jordi2224/DQNavigator/Figure_1.png

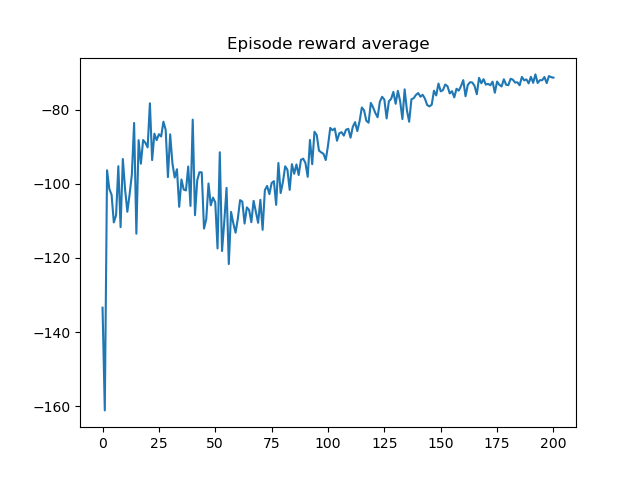
Figure_1.png
