jordi2224/DQNavigator/model.png

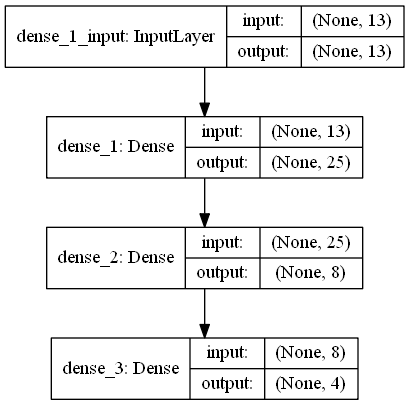
model.png
