jordi2224/DQNavigator/model_plot.png

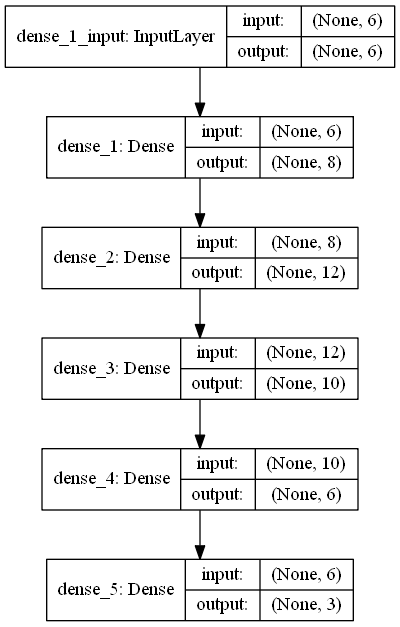
model_plot.png
