jordi2224/DQNavigator/preprocessing/decimated.png

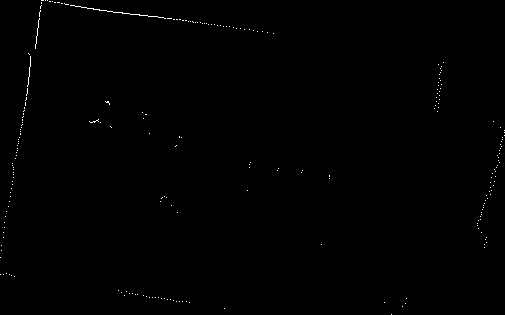
preprocessing/decimated.png
