jordi2224/DQNavigator/preprocessing/grids/grid0.png

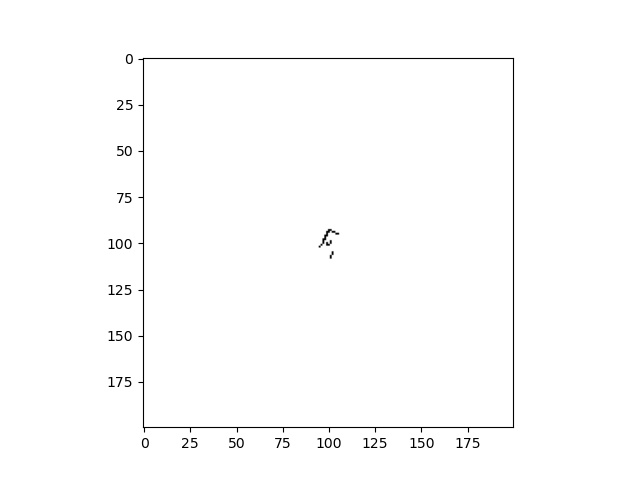
preprocessing/grids/grid0.png
