jordi2224/DQNavigator/preprocessing/grids/grid1.png

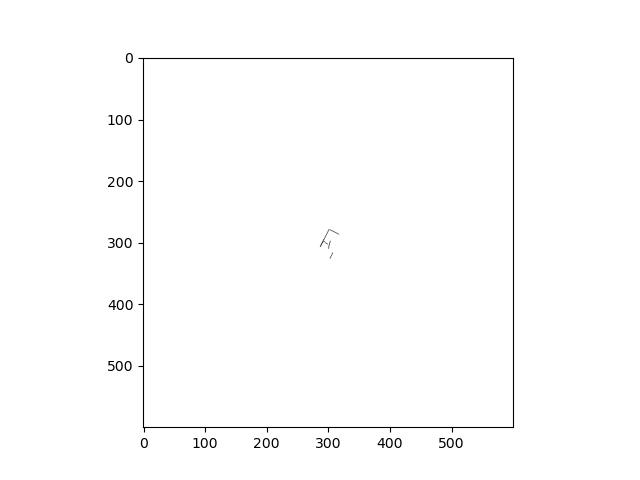
preprocessing/grids/grid1.png
