jordi2224/DQNavigator/preprocessing/grids/grid7.png

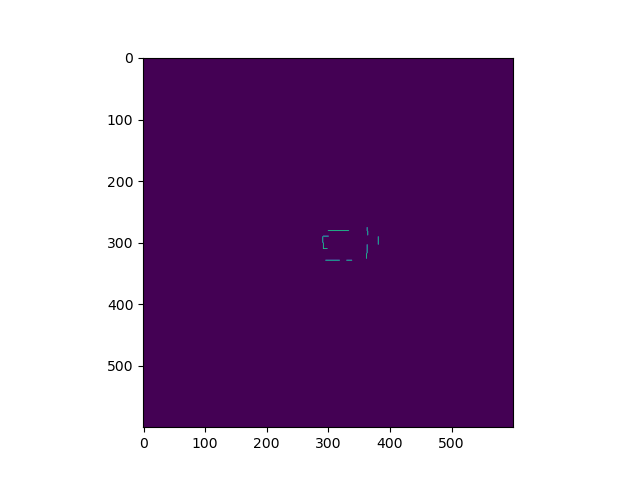
preprocessing/grids/grid7.png
