jordi2224/DQNavigator/preprocessing/grids/grid14.png

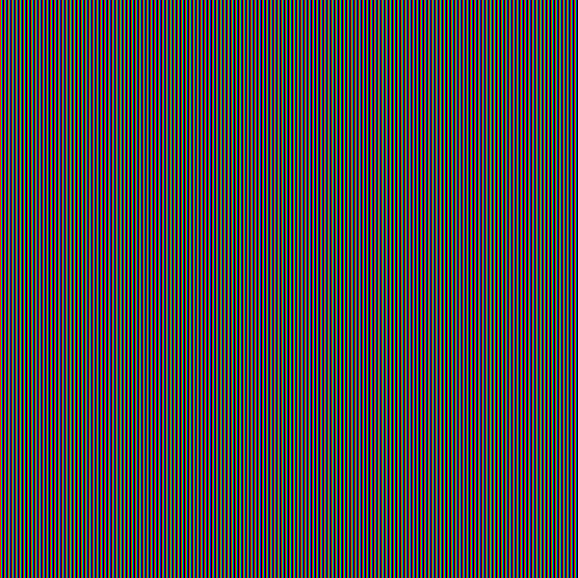
preprocessing/grids/grid14.png
