jordi2224/DQNavigator/preprocessing/sc_grids/grid2.png

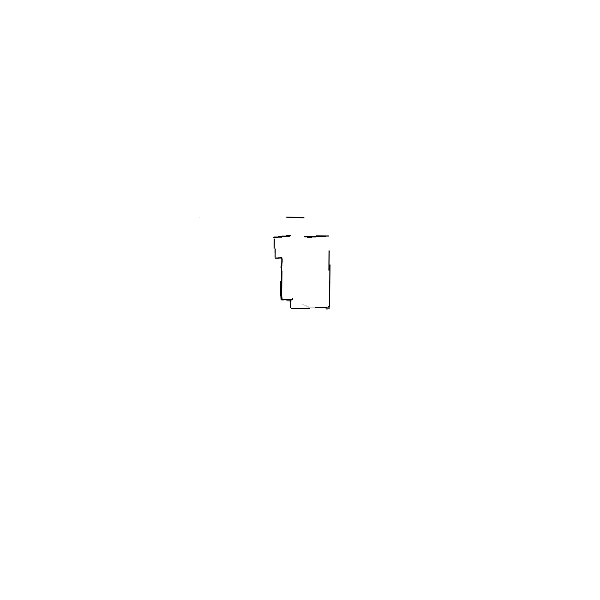
preprocessing/sc_grids/grid2.png
