jordi2224/DQNavigator/hardware/ROVER/LIDAR_support.stl

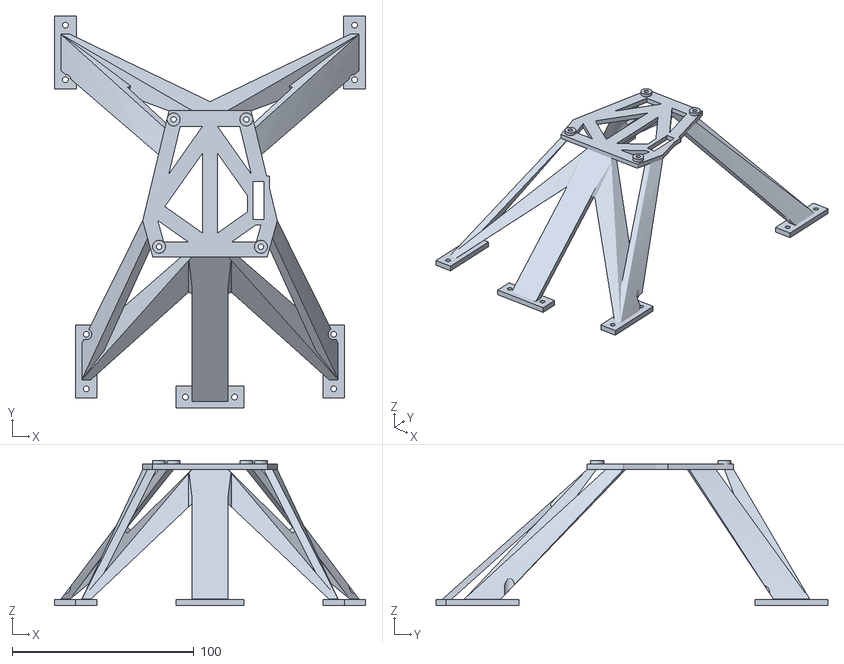
[picture p10: CAD file, 2020-07-13]
hardware/ROVER/LIDAR_support.stl
171.0 x 215.5 x 80.0
