jordi2224/DQNavigator/hardware/ROVER/PCB_deck.stl

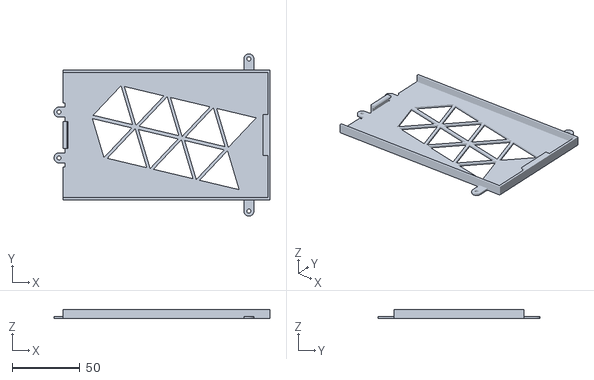
[picture p11: CAD file, 2020-07-13]
hardware/ROVER/PCB_deck.stl
159.3 x 119.6 x 7.00
