jordi2224/DQNavigator/hardware/ROVER/battery-strap casing.stl

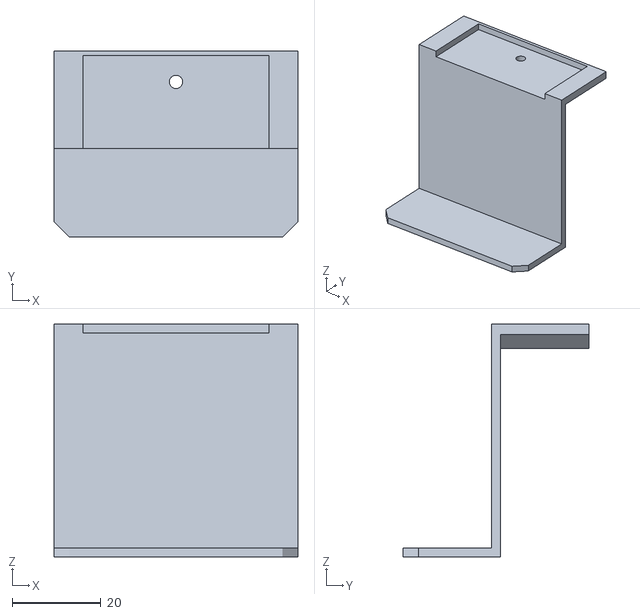
[picture p12: CAD file, 2020-04-13]
hardware/ROVER/battery-strap casing.stl
55.0 x 42.0 x 52.5
