jordi2224/DQNavigator/hardware/ROVER/battery-strap -under.stl

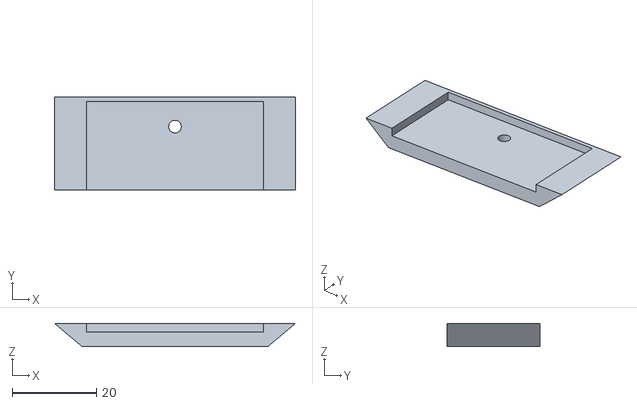
[picture p13: CAD file, 2020-04-13]
hardware/ROVER/battery-strap -under.stl
57.1 x 22.0 x 5.50
