jordi2224/DQNavigator/hardware/ROVER/stabilizer.stl

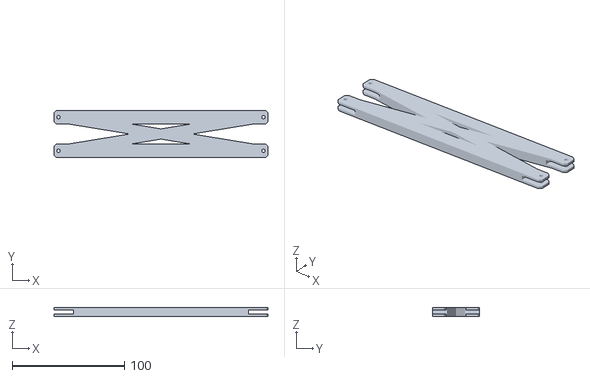
[picture p14: CAD file, 2020-04-13]
hardware/ROVER/stabilizer.stl
191.0 x 42.0 x 7.60
