jordi2224/DQNavigator/hardware/ROVER/Deck.stl

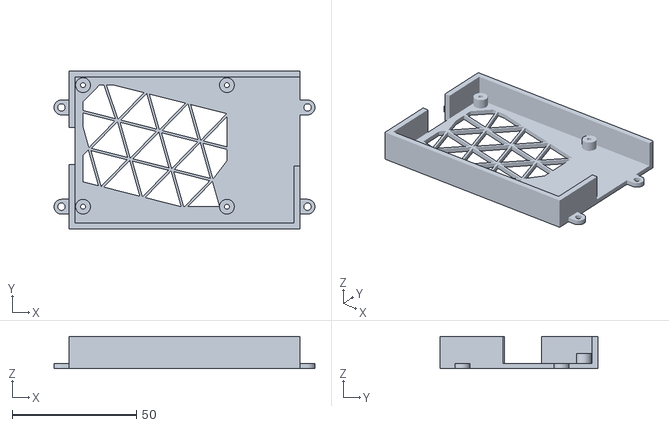
[picture p15: CAD file, 2020-04-13]
hardware/ROVER/Deck.stl
105.2 x 63.7 x 13.0
