jordi2224/DQNavigator/hardware/ROVER/Tplug.stl

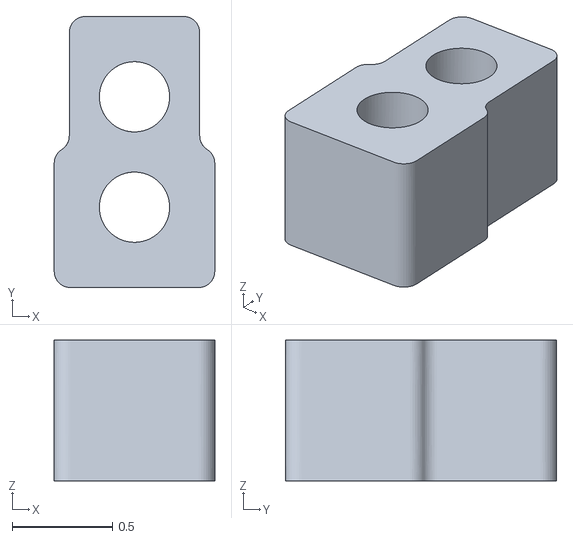
[picture p16: CAD file, 2020-04-13]
hardware/ROVER/Tplug.stl
0.8 x 1.35 x 0.7
