jordi2224/DQNavigator/hardware/ROVER/washer.stl

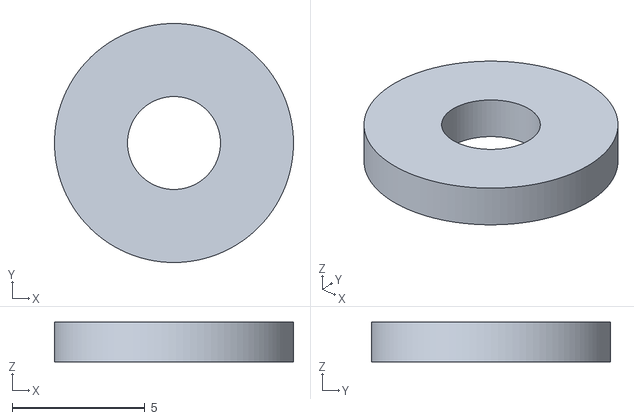
[picture p17: CAD file, 2020-04-13]
hardware/ROVER/washer.stl
9.00 x 9.00 x 1.50
