jordi2224/DQNavigator/(list of files, cad)

Other CAD files:
hardware/ROVER/Deck0.SLDPRT
hardware/ROVER/Deck.ipt
hardware/ROVER/LIDAR_support.idw
hardware/ROVER/LIDAR_support.ipt
hardware/ROVER/OldVersions/Deck.0004.ipt
hardware/ROVER/OldVersions/LIDAR_support.0001.idw
hardware/ROVER/OldVersions/LIDAR_support.0010.ipt
hardware/ROVER/OldVersions/PCB_deck.0003.ipt
hardware/ROVER/OldVersions/Part3.0001.ipt
hardware/ROVER/OldVersions/Tplug-Male.0008.ipt
hardware/ROVER/OldVersions/Tplug.0004.ipt
hardware/ROVER/OldVersions/battery-strap -under.0001.ipt
hardware/ROVER/OldVersions/decks.0003.idw
hardware/ROVER/OldVersions/floormap2.0002.idw
hardware/ROVER/OldVersions/floormap2.0004.ipt
hardware/ROVER/OldVersions/full_assembly.0002.idw
hardware/ROVER/OldVersions/full_assembly.0006.iam
hardware/ROVER/OldVersions/motor_body.0001.ipt
hardware/ROVER/OldVersions/motor_core.0001.iam
hardware/ROVER/OldVersions/motor_plus_encoder.0001.iam
hardware/ROVER/OldVersions/motor_plus_encoder.0001.idw
hardware/ROVER/OldVersions/platform.0007.idw
hardware/ROVER/OldVersions/platform.0010.iam
hardware/ROVER/OldVersions/platform_motor.0003.ipt
hardware/ROVER/OldVersions/platform_sprocket.0002.ipt
hardware/ROVER/OldVersions/platform_track_support.0008.ipt
hardware/ROVER/OldVersions/platform_track_support_inv.0001.ipt
hardware/ROVER/OldVersions/platform_wheel.0002.ipt
hardware/ROVER/OldVersions/stabilizer.0009.ipt
hardware/ROVER/OldVersions/washer.0002.ipt
hardware/ROVER/PCB_deck.dwg
hardware/ROVER/PCB_deck.ipt
hardware/ROVER/Part1.ipt
hardware/ROVER/Part3.ipt
hardware/ROVER/Tplug-Male.ipt
hardware/ROVER/Tplug.dwg
hardware/ROVER/Tplug.ipt
hardware/ROVER/battery-strap -under.ipt
hardware/ROVER/battery-strap casing.ipt
hardware/ROVER/battery-strap.idw
hardware/ROVER/decks.idw
hardware/ROVER/encoder_pole.ipt
hardware/ROVER/encoder_sensor.ipt
hardware/ROVER/floormap-1.idw
hardware/ROVER/floormap.ipt
hardware/ROVER/floormap2.idw
hardware/ROVER/floormap2.ipt
hardware/ROVER/full_assembly.iam
hardware/ROVER/full_assembly.idw
hardware/ROVER/gearbox.ipt
hardware/ROVER/motor.iam
hardware/ROVER/motor_body.ipt
hardware/ROVER/motor_core.iam
hardware/ROVER/motor_plus_encoder.iam
hardware/ROVER/motor_plus_encoder.idw
hardware/ROVER/pcb.ipt
hardware/ROVER/platform.iam
hardware/ROVER/platform.idw
hardware/ROVER/platform_board.idw
hardware/ROVER/platform_board.ipt
hardware/ROVER/platform_motor.ipt
hardware/ROVER/platform_sprocket.ipt
hardware/ROVER/platform_track_support.ipt
hardware/ROVER/platform_track_support_inv.ipt
hardware/ROVER/platform_wheel.ipt
hardware/ROVER/raspberry.ipt
hardware/ROVER/shaft.ipt
hardware/ROVER/stabilizer.idw
hardware/ROVER/stabilizer.ipt
hardware/ROVER/washer.ipt
