jordi2224/DQNavigator/TODO.txt

Neural Net Training:
	HyperParameter tuning
	Actual training

Data Preprocessing
	Turn driver into object
	Find walls; Using houghlinesP?
	Find hazards
	
Hardware
	Finish Hbridge and current sensing
	Hall effect sensor
	Footprints
	PCB design
	PCB manufacturing
	Assembling

Async movement tracking -> multi threading
Positioning system
Map
Remove dsize dependency

Code Refactor and project cleanup
