jordi2224/DQNavigator/hardware/ROVER/LIDAR_support.pdf

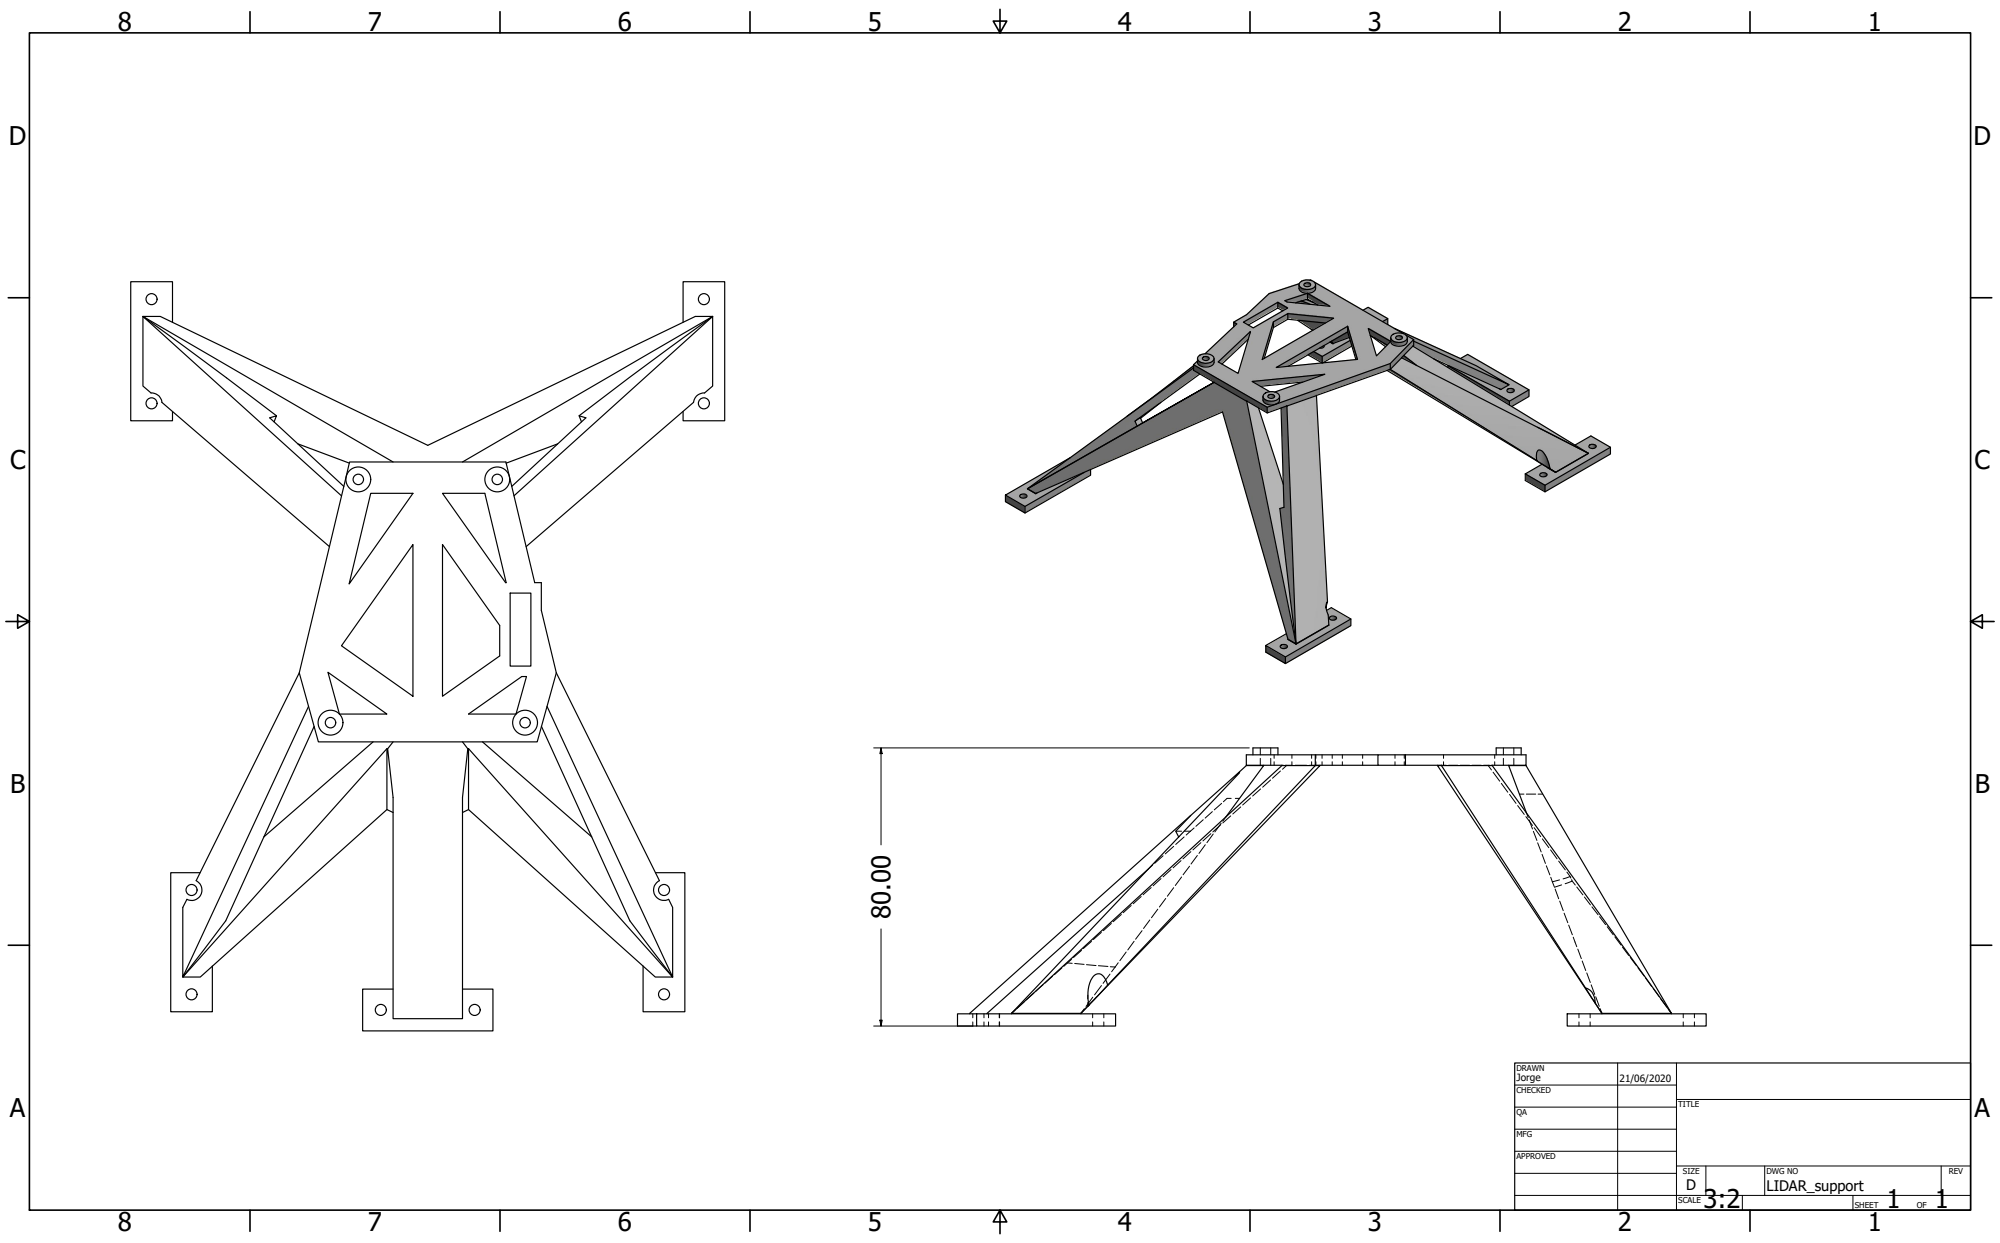
[picture p18: page 1]

DRAWN Jorge | 21/06/2020

CHECKED

MFG

APPROVED

SIZE D | DWG NO LIDAR_support | REV

3:2 SCALE | | SHEET 1 OF 1
