jordi2224/DQNavigator/hardware/ROVER/motor_plus_encoder.pdf

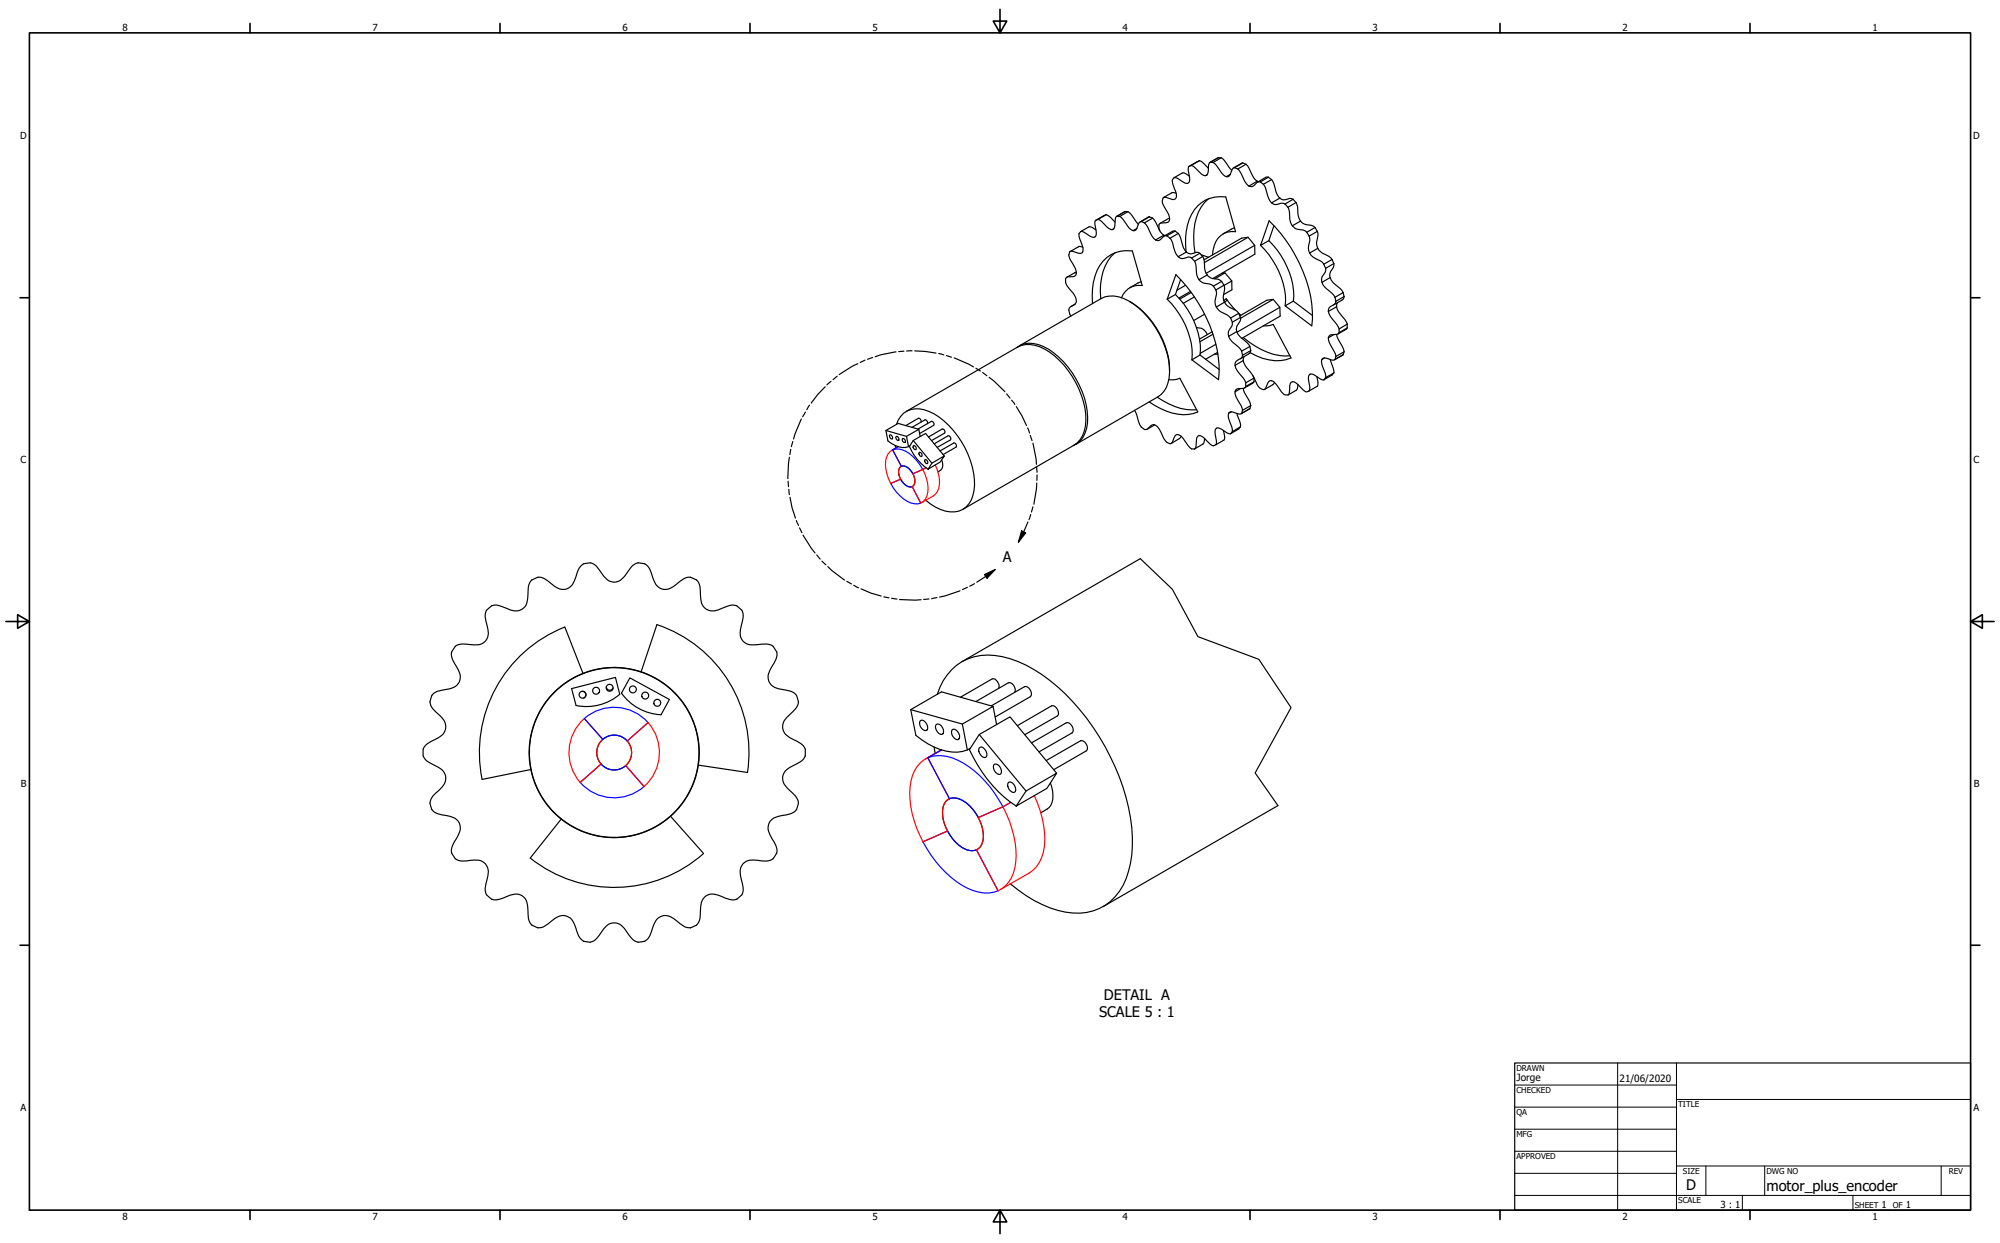
[picture p19: page 1]
DETAIL A SCALE 5 : 1

DRAWN Jorge | 21/06/2020

CHECKED

MFG

APPROVED

SIZE D | DWG NO motor_plus_encoder | REV

SCALE 3 : 1 | | SHEET 1 OF 1
