jordi2224/DQNavigator/hardware/ROVER/decks.pdf

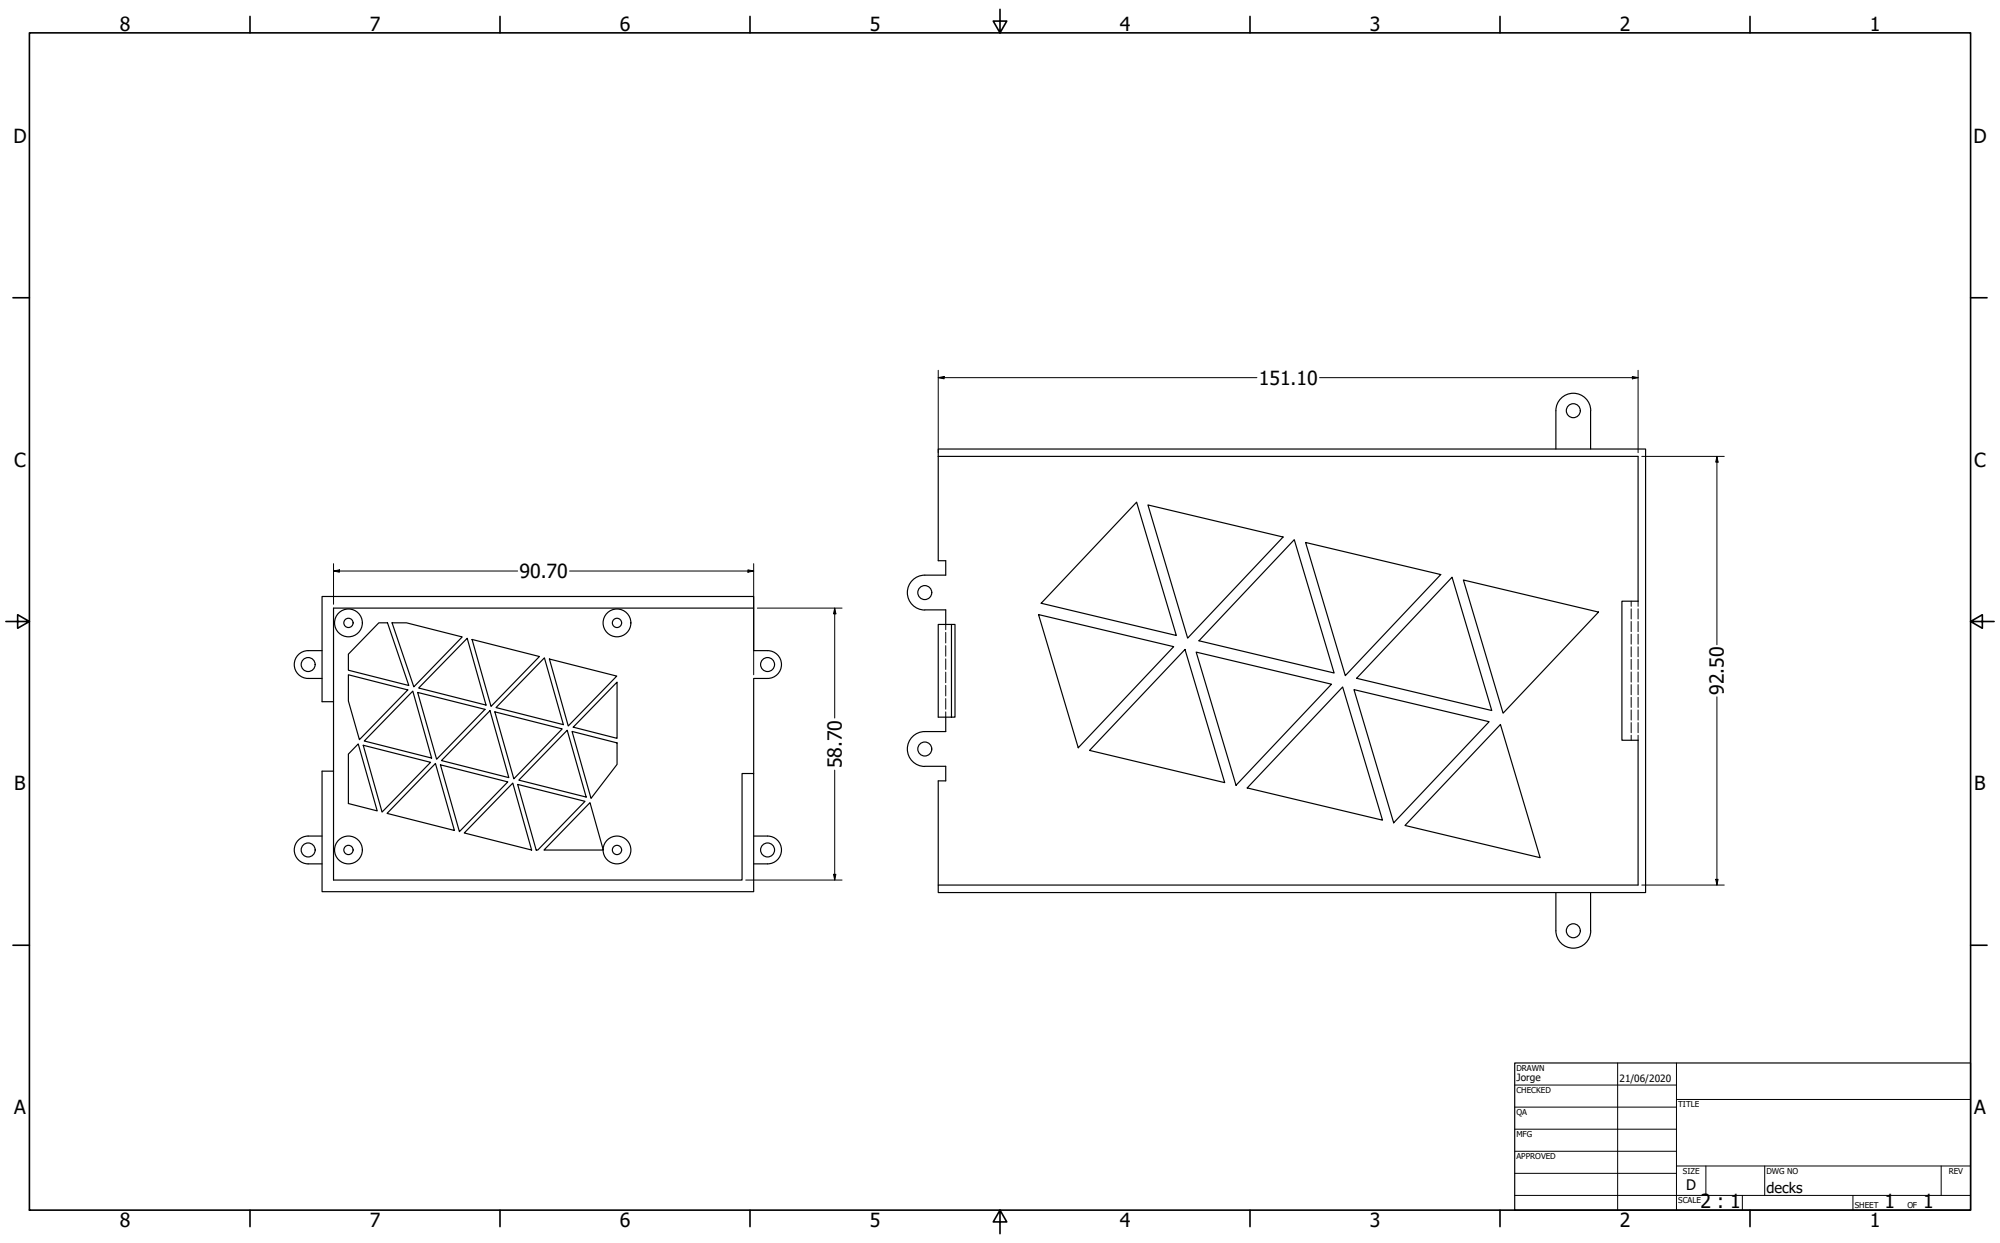
[picture p20: page 1]
