jordi2224/DQNavigator/hardware/ROVER/floormap-1.pdf

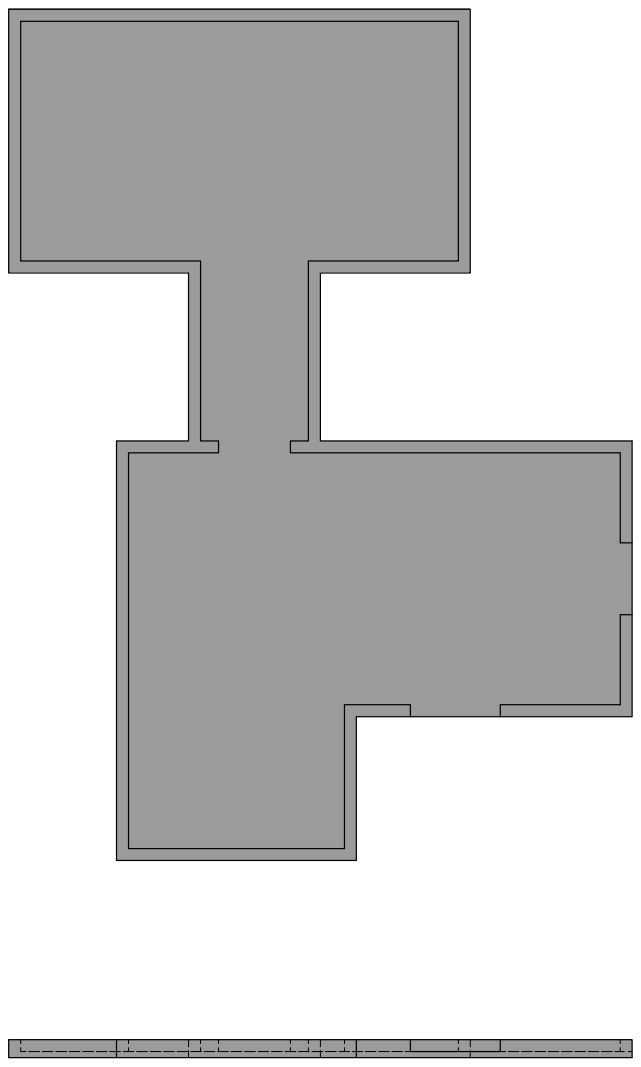
[picture p21: page 1]

DRAWN Jorge | 17/06/2020

CHECKED

MFG

APPROVED

SIZE D | DWG NO | REV

SCALE 1 / 40 | | SHEET 1 OF 1
