jordi2224/DQNavigator/hardware/ROVER/floormap2.pdf

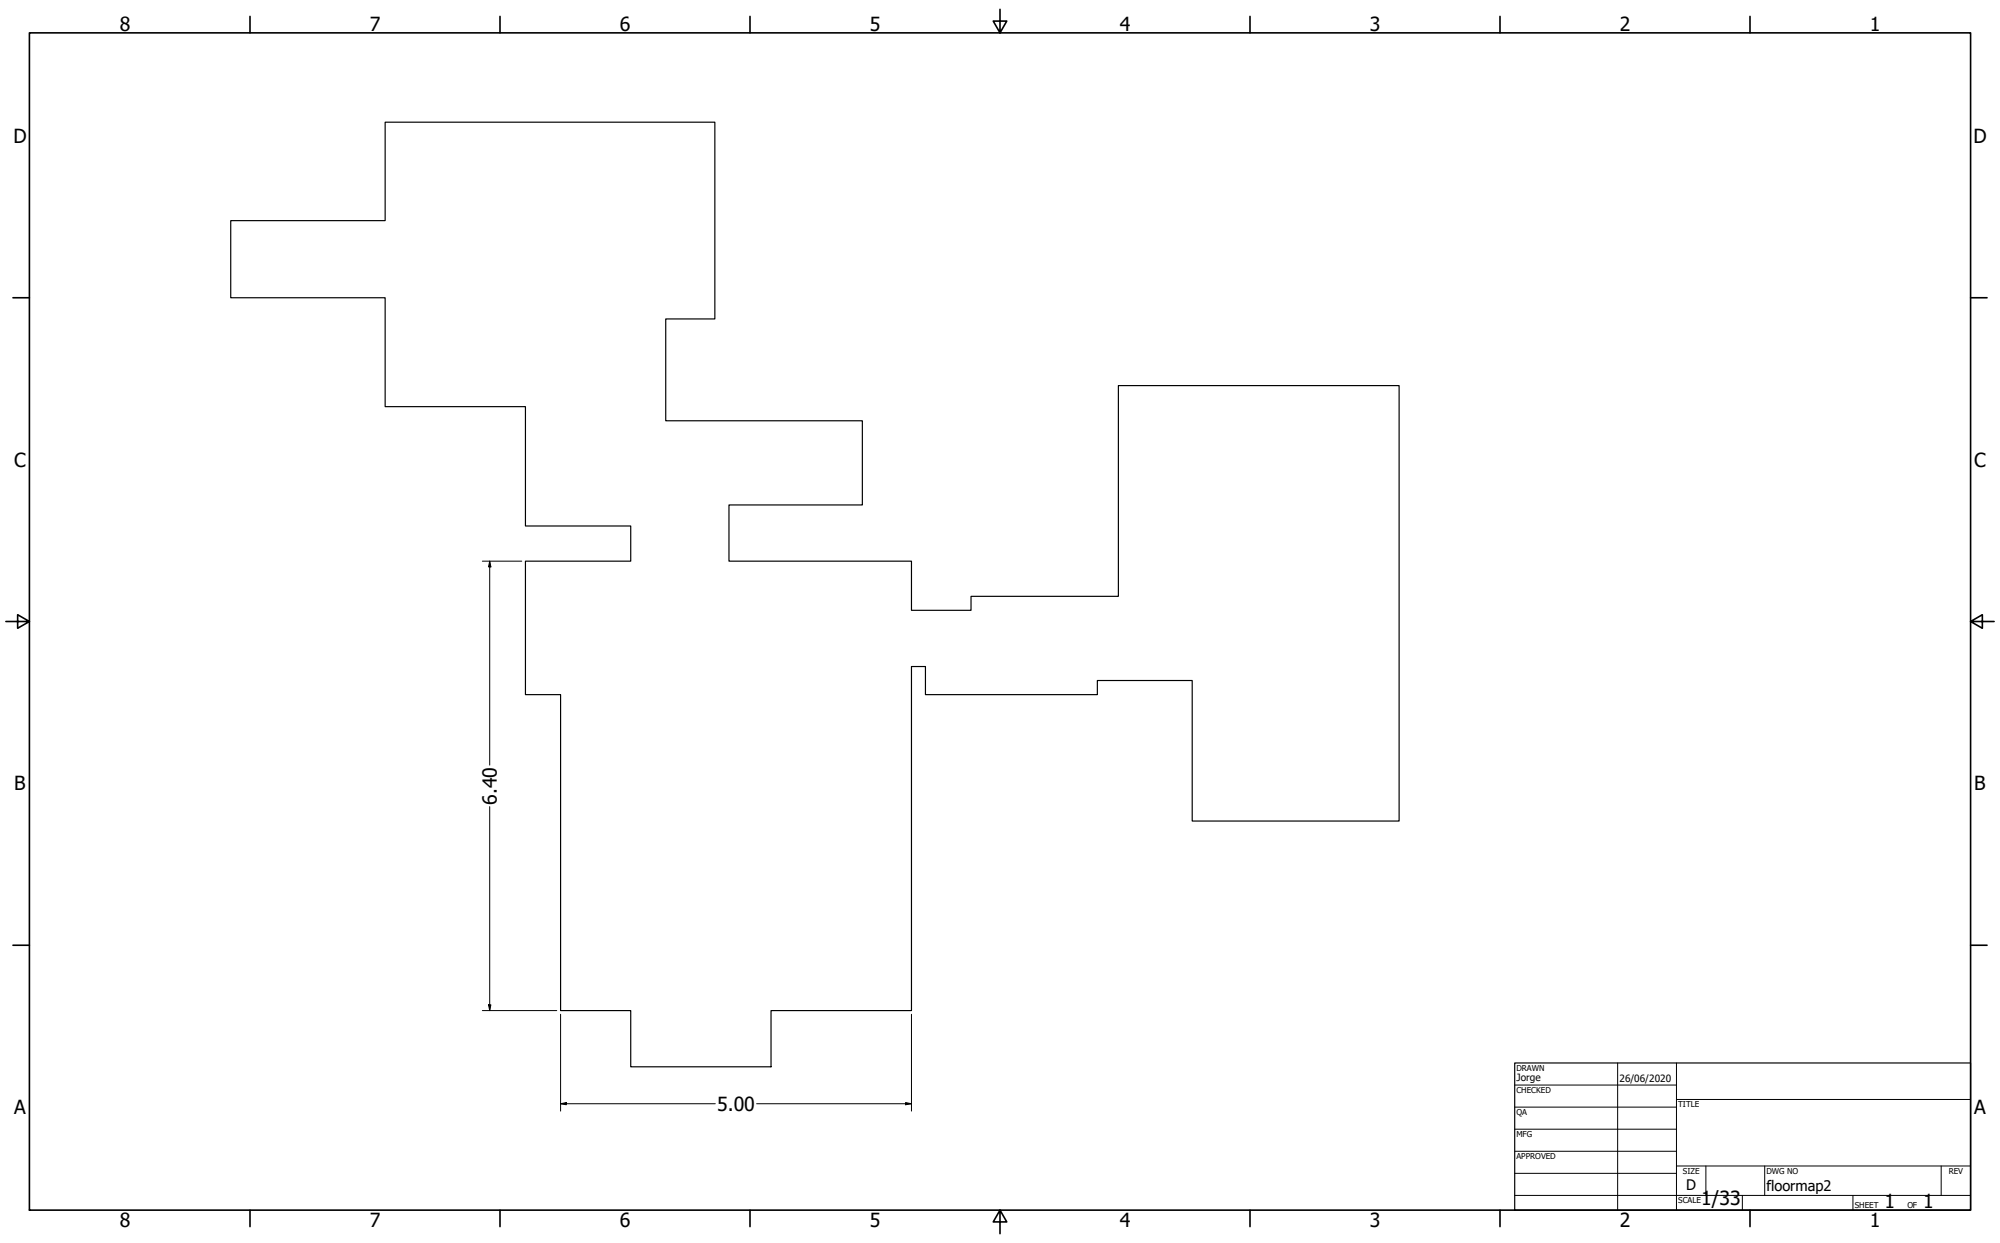
[picture p22: page 1]

DRAWN Jorge | 26/06/2020

CHECKED

MFG

APPROVED

SIZE D | DWG NO floormap2 | REV

1/33 SCALE | | SHEET 1 OF 1
