jordi2224/DQNavigator/hardware/ROVER/full_assembly.pdf

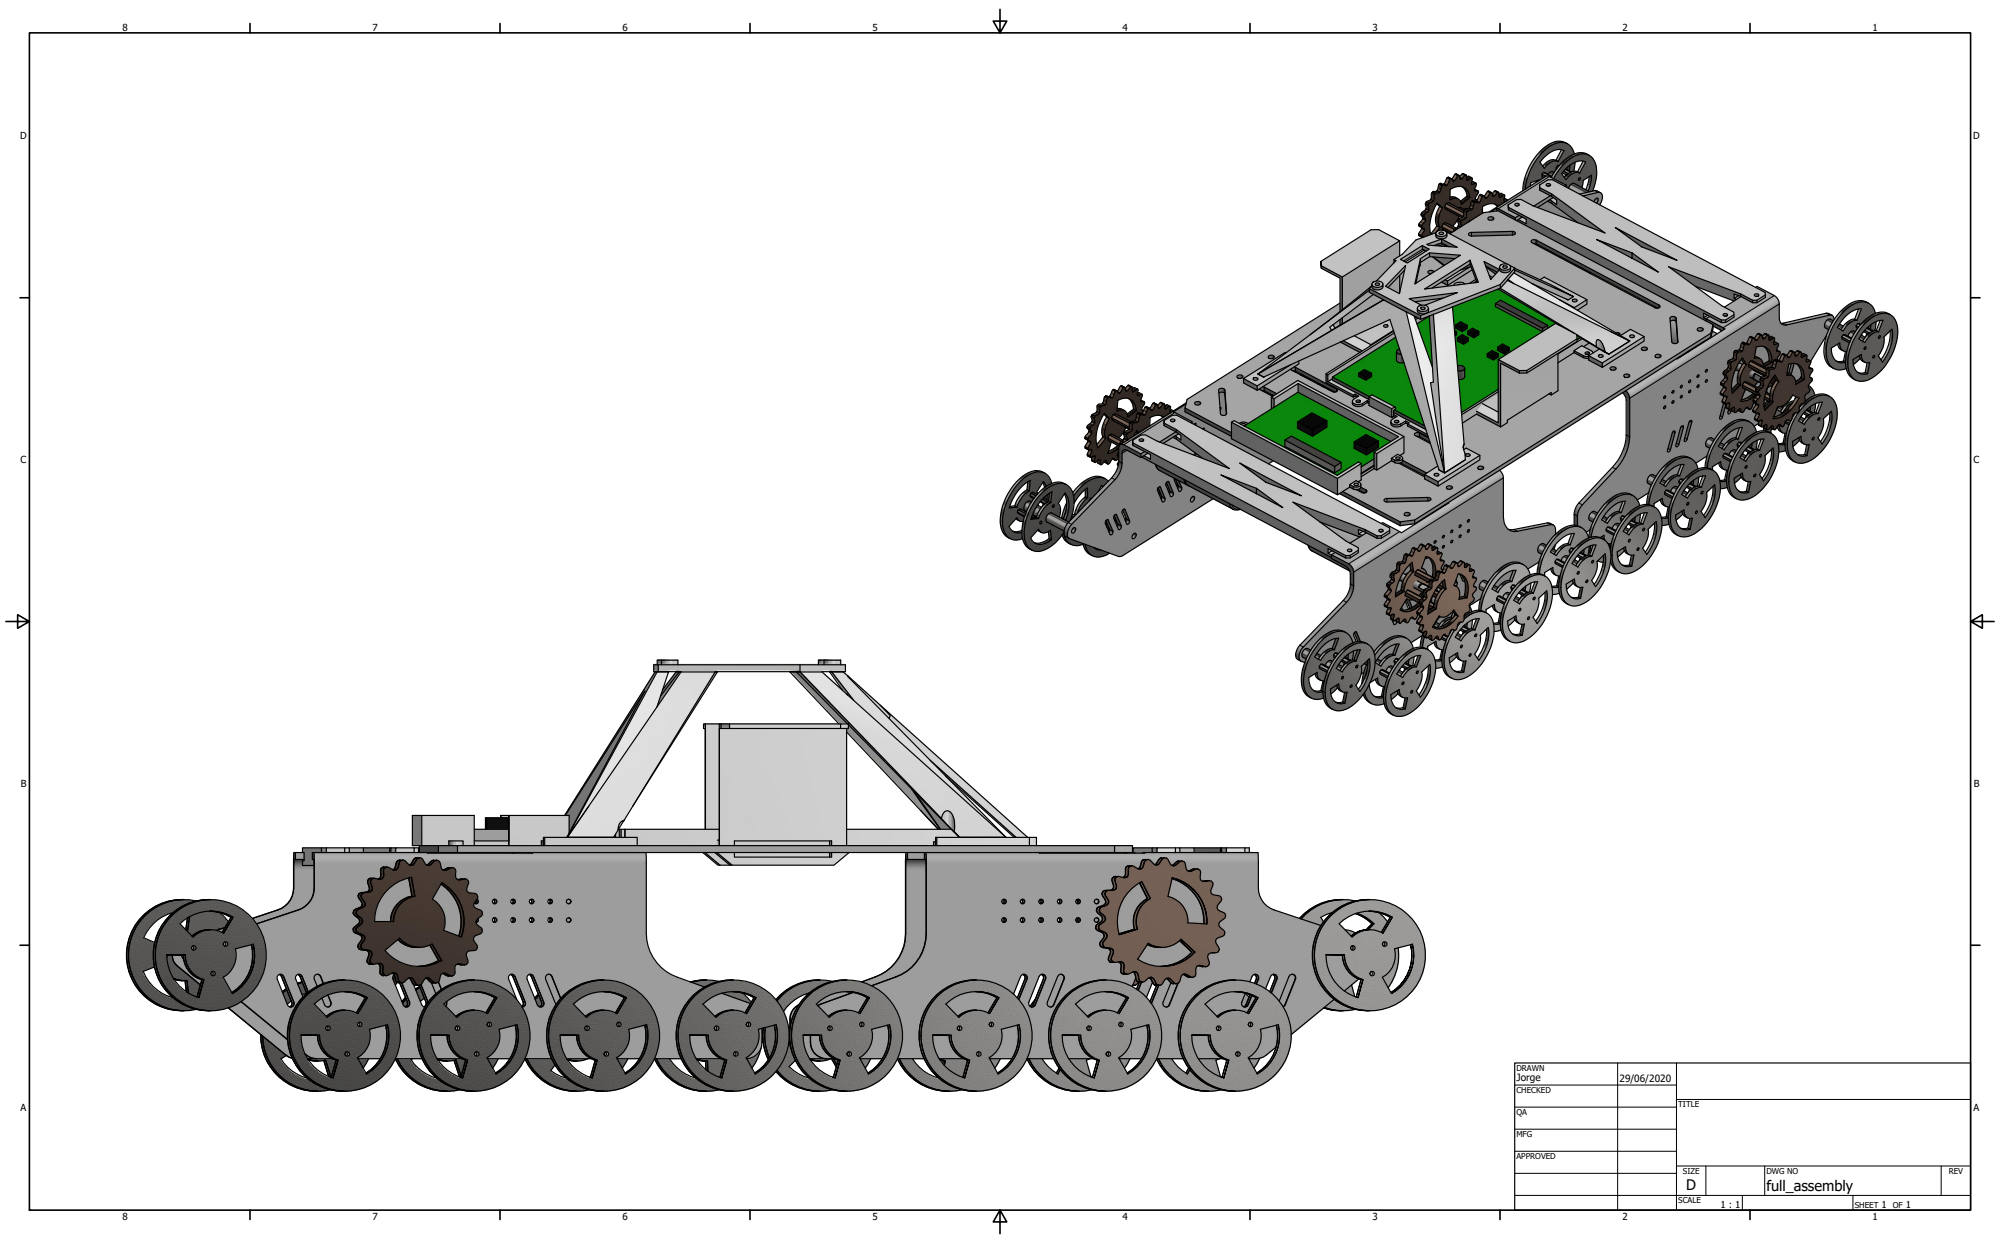
[picture p23: page 1]

DRAWN Jorge | 29/06/2020

CHECKED

MFG

APPROVED

SIZE D | DWG NO full_assembly | REV

SCALE 1 : 1 | | SHEET 1 OF 1
