jordi2224/DQNavigator/hardware/ROVER/platform.pdf

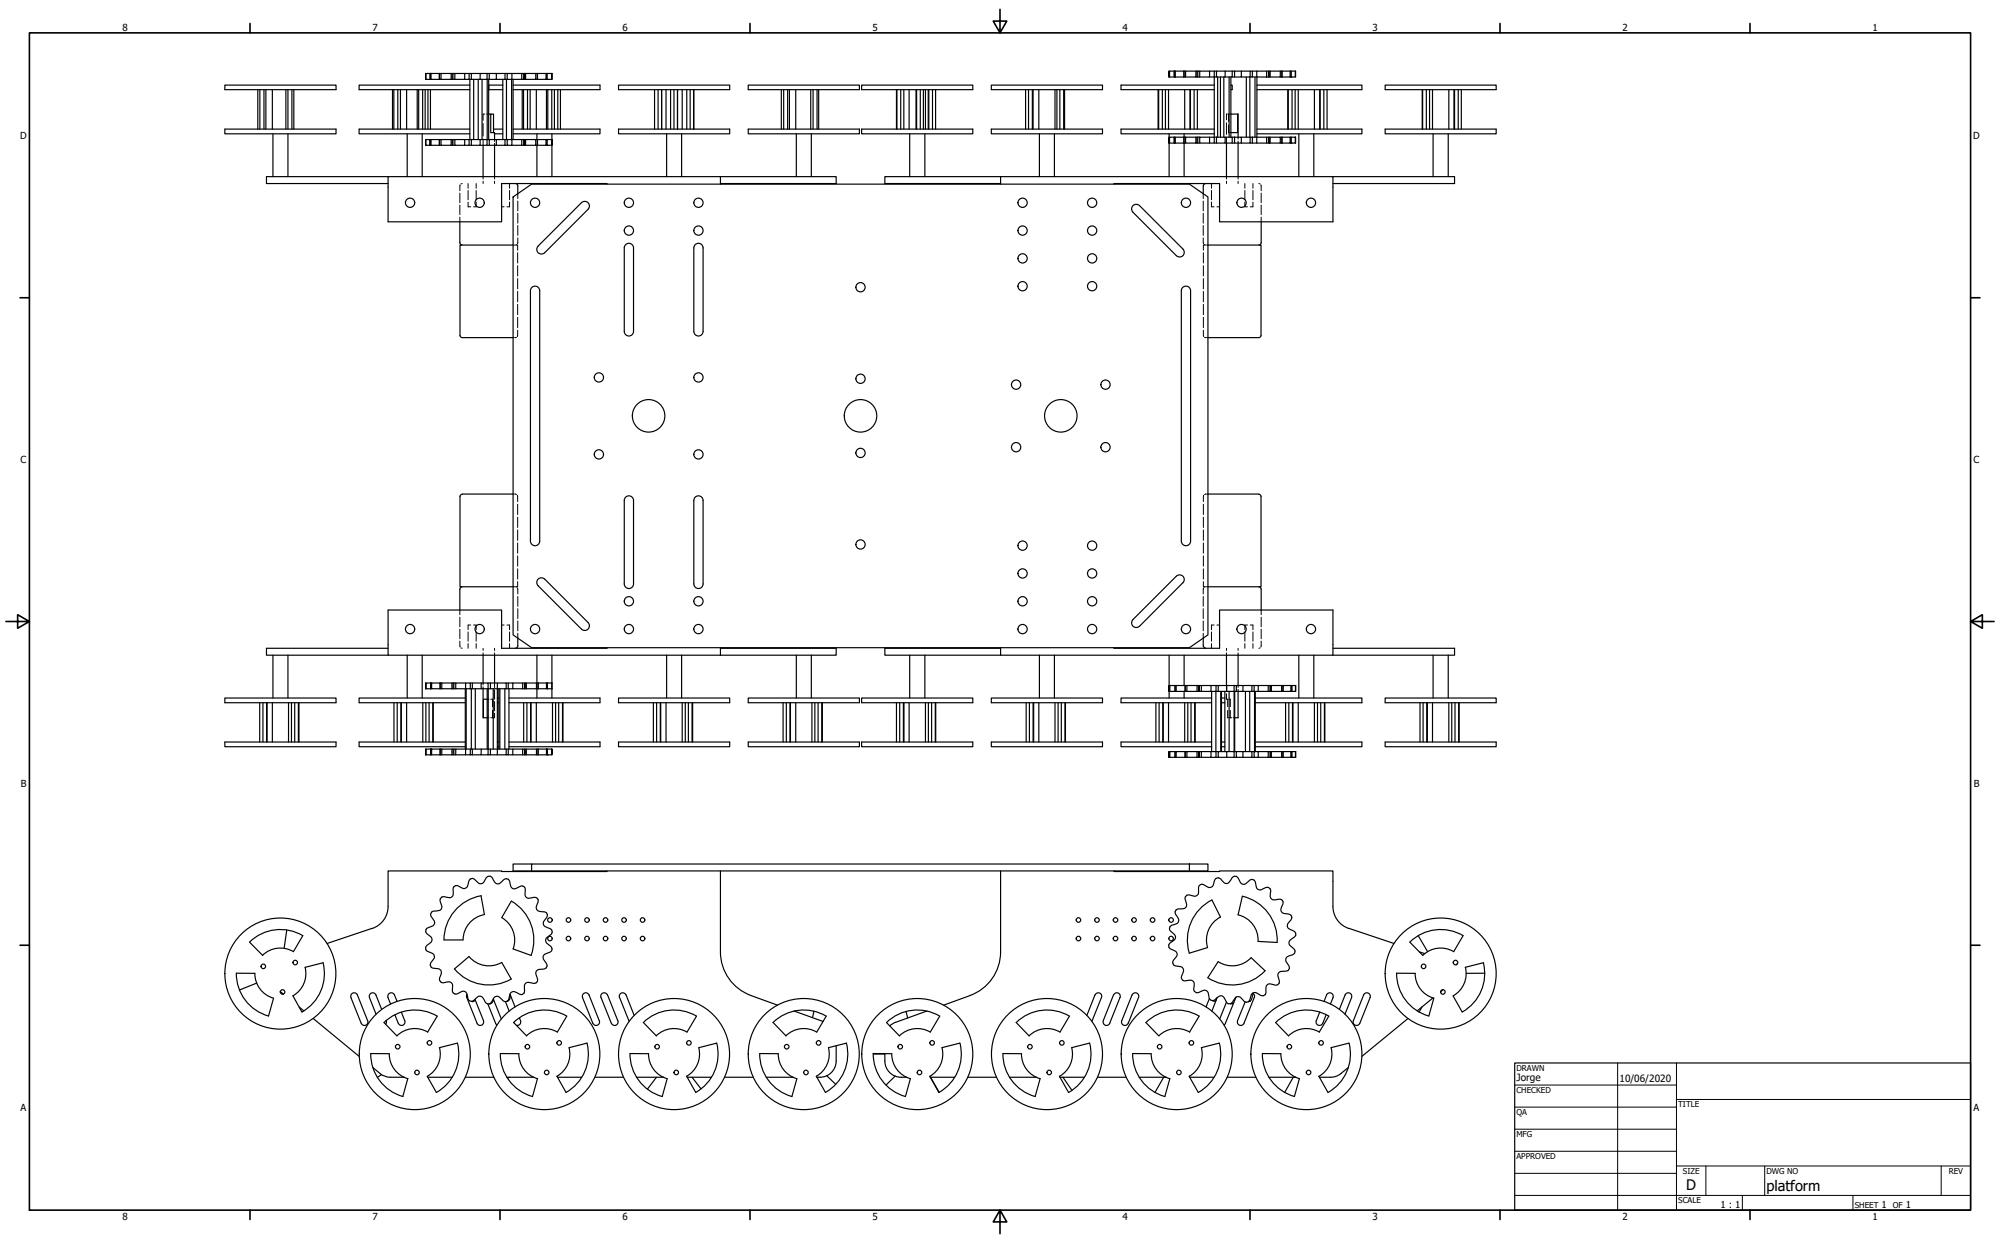
[picture p24: page 1]

DRAWN Jorge | 10/06/2020

CHECKED

MFG

APPROVED

SIZE D | DWG NO platform | REV

SCALE 1 : 1 | | SHEET 1 OF 1
