jordi2224/DQNavigator/hardware/ROVER/stabilizer.pdf

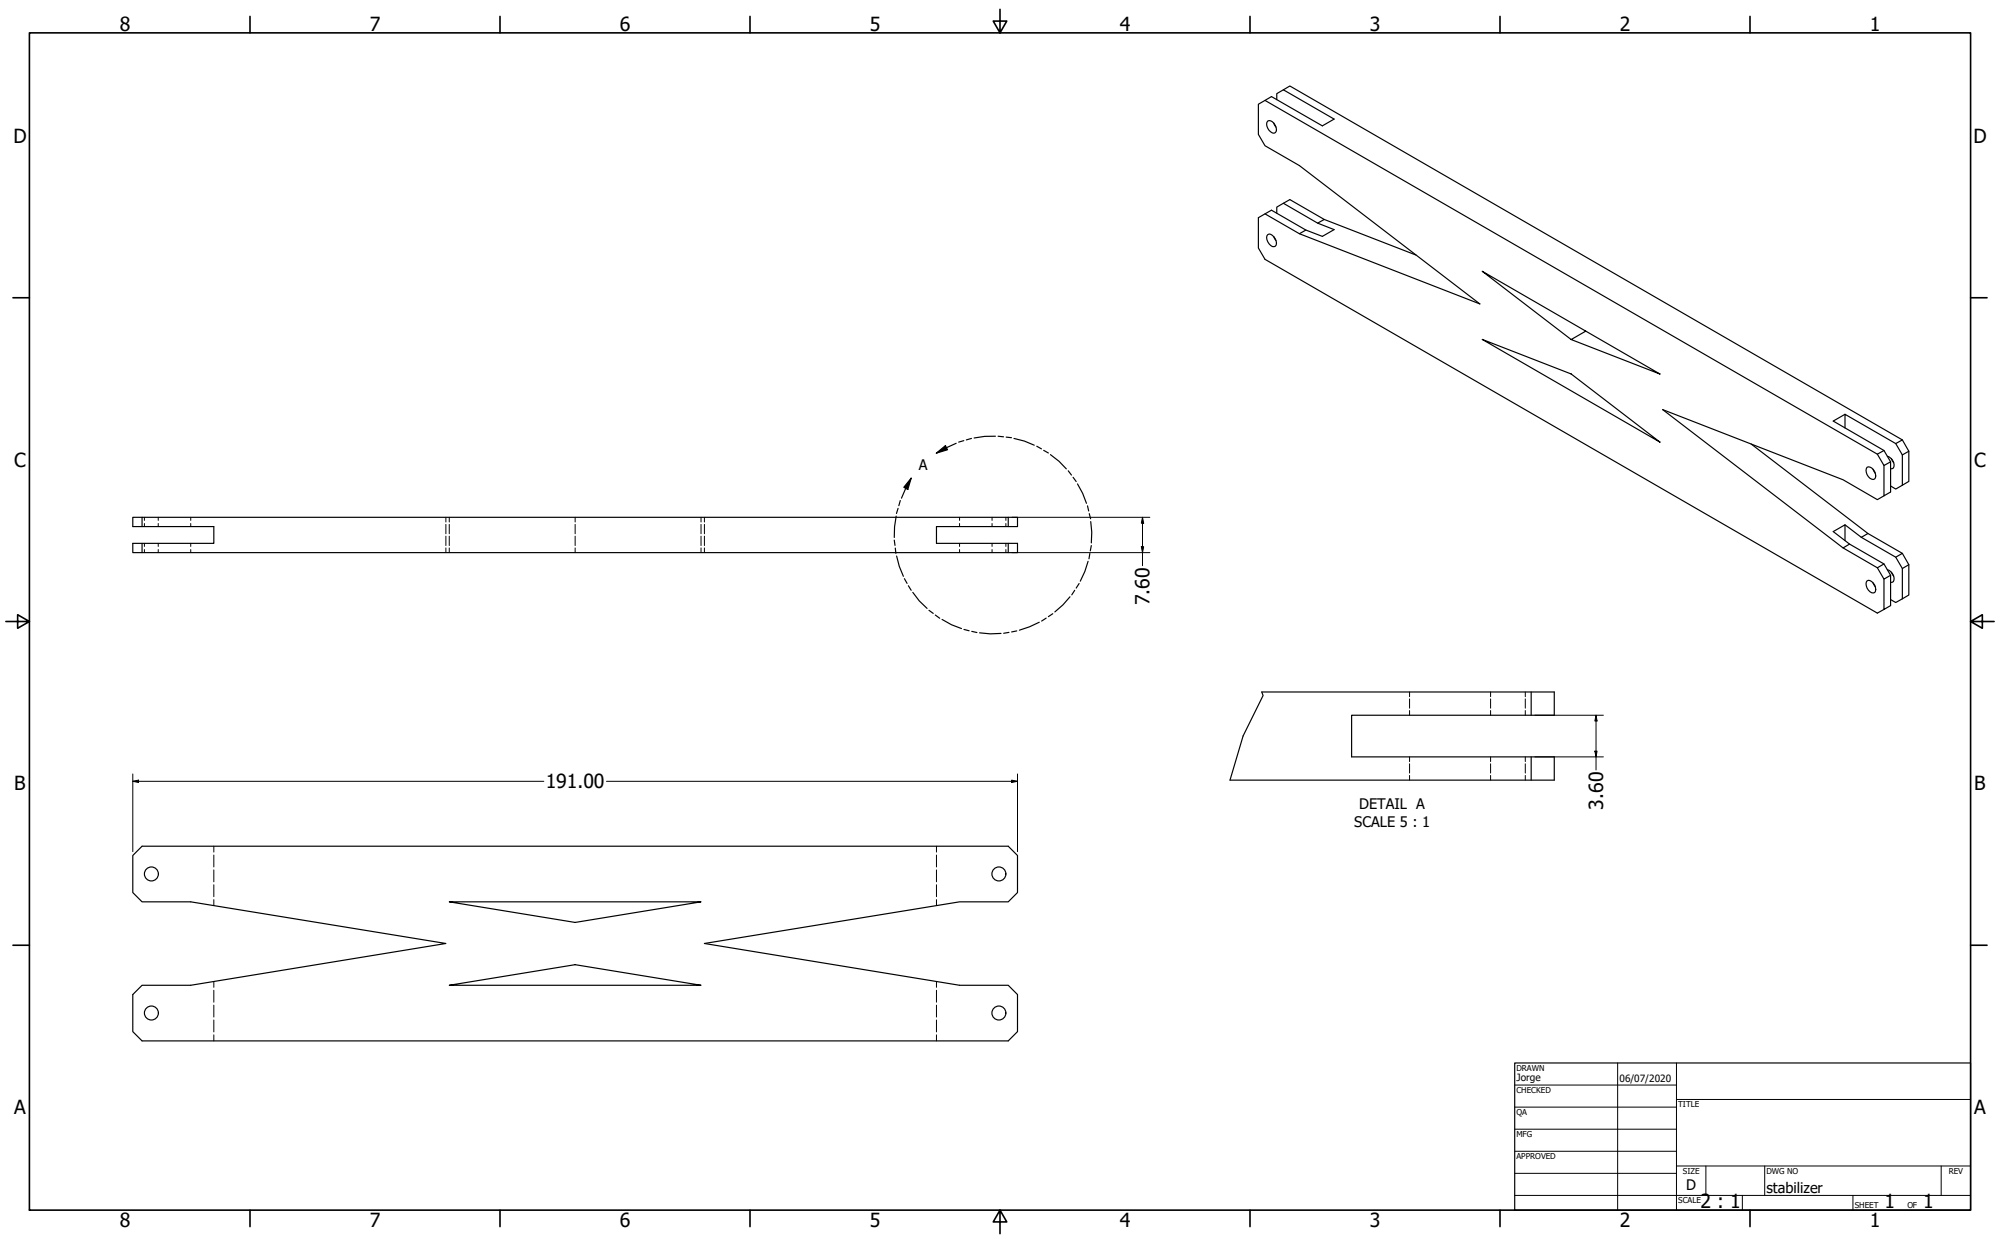
[picture p25: page 1]
DETAIL A SCALE 5 : 1

DRAWN Jorge | 06/07/2020

CHECKED

MFG

APPROVED

SIZE D | DWG NO stabilizer | REV

2 : 1 SCALE | | SHEET 1 OF 1
