jordi2224/DQNavigator/hardware/ROVER/Tplug.pdf

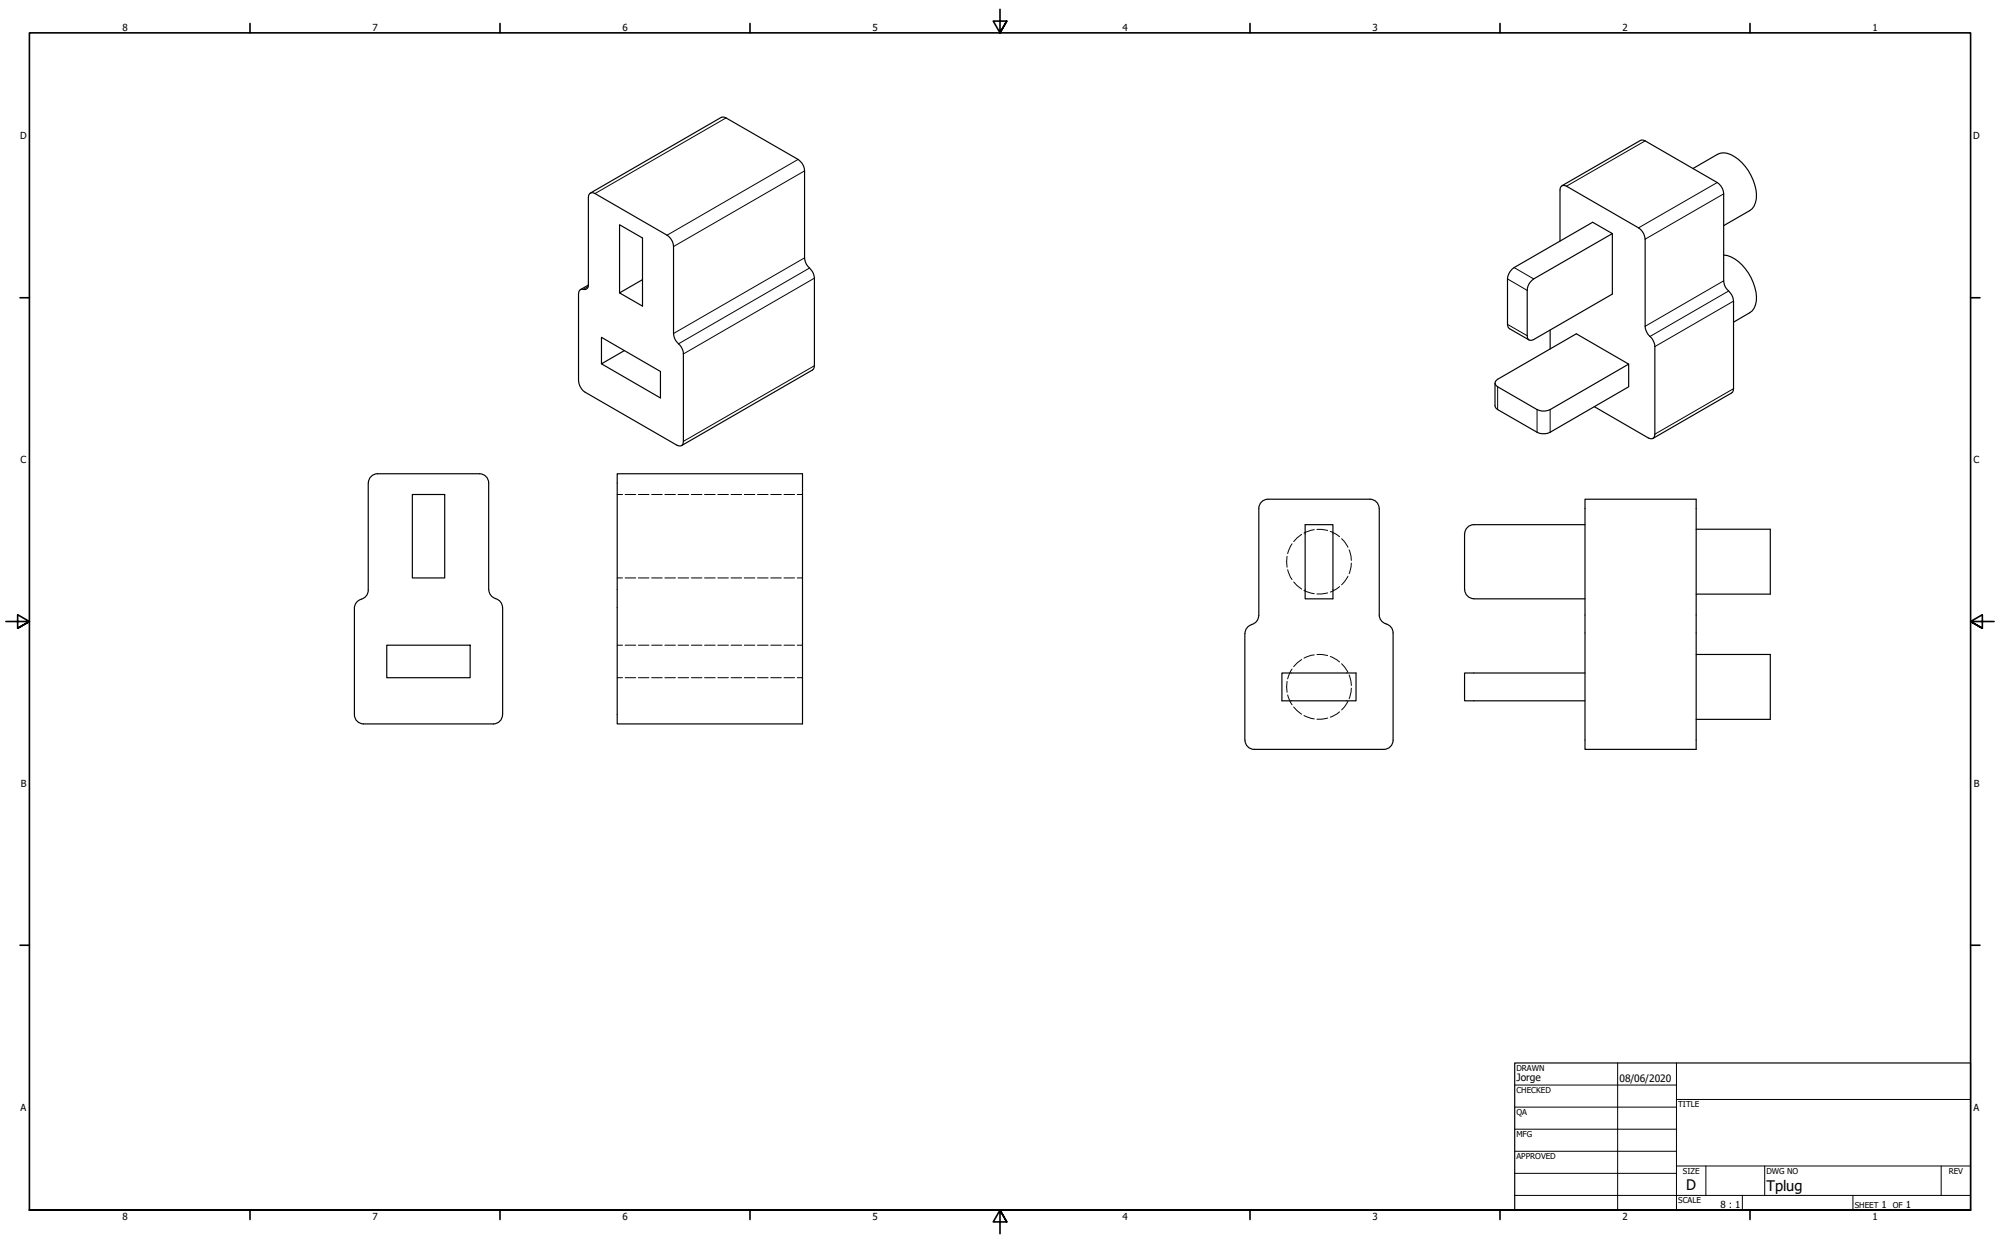
[picture p26: page 1]

DRAWN Jorge | 08/06/2020

CHECKED

MFG

APPROVED

SIZE D | DWG NO Tplug | REV

SCALE 8 : 1 | | SHEET 1 OF 1
