jordi2224/DQNavigator/hardware/PCB/TFG_PCB/pcb.pdf

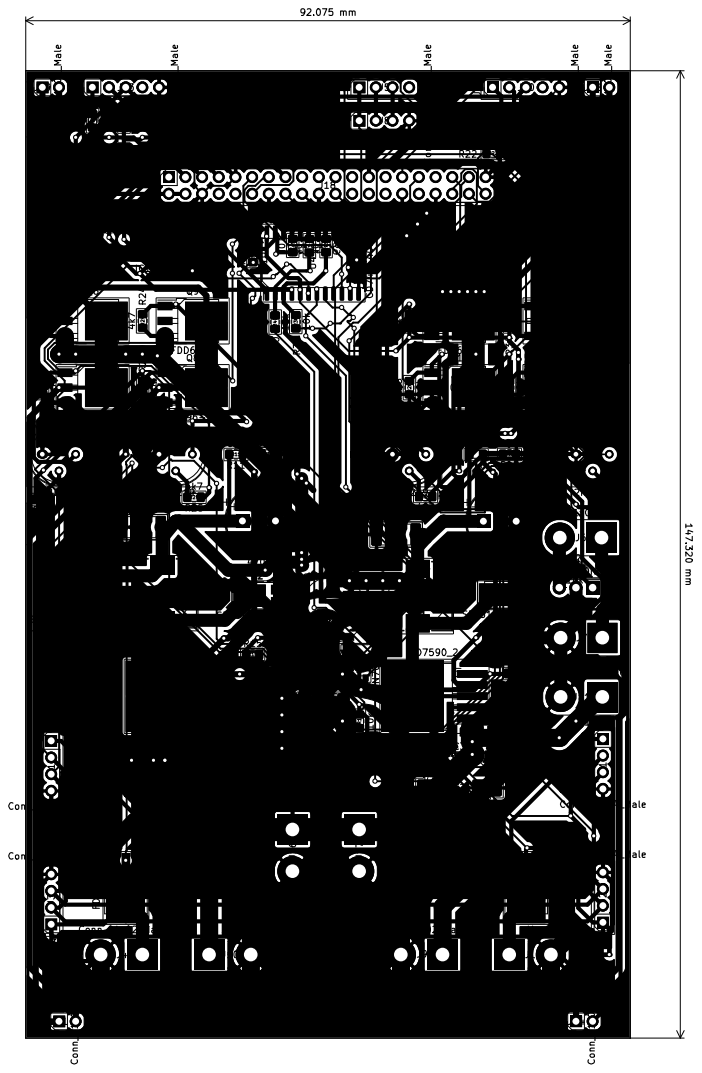
[picture p27: page 1]
