jordi2224/DQNavigator/hardware/PCB/TFG_PCB/TFG_PCB.kicad_pcb

## KiCad design hardware/PCB/TFG_PCB/TFG_PCB.kicad_pcb (2020-03-16)

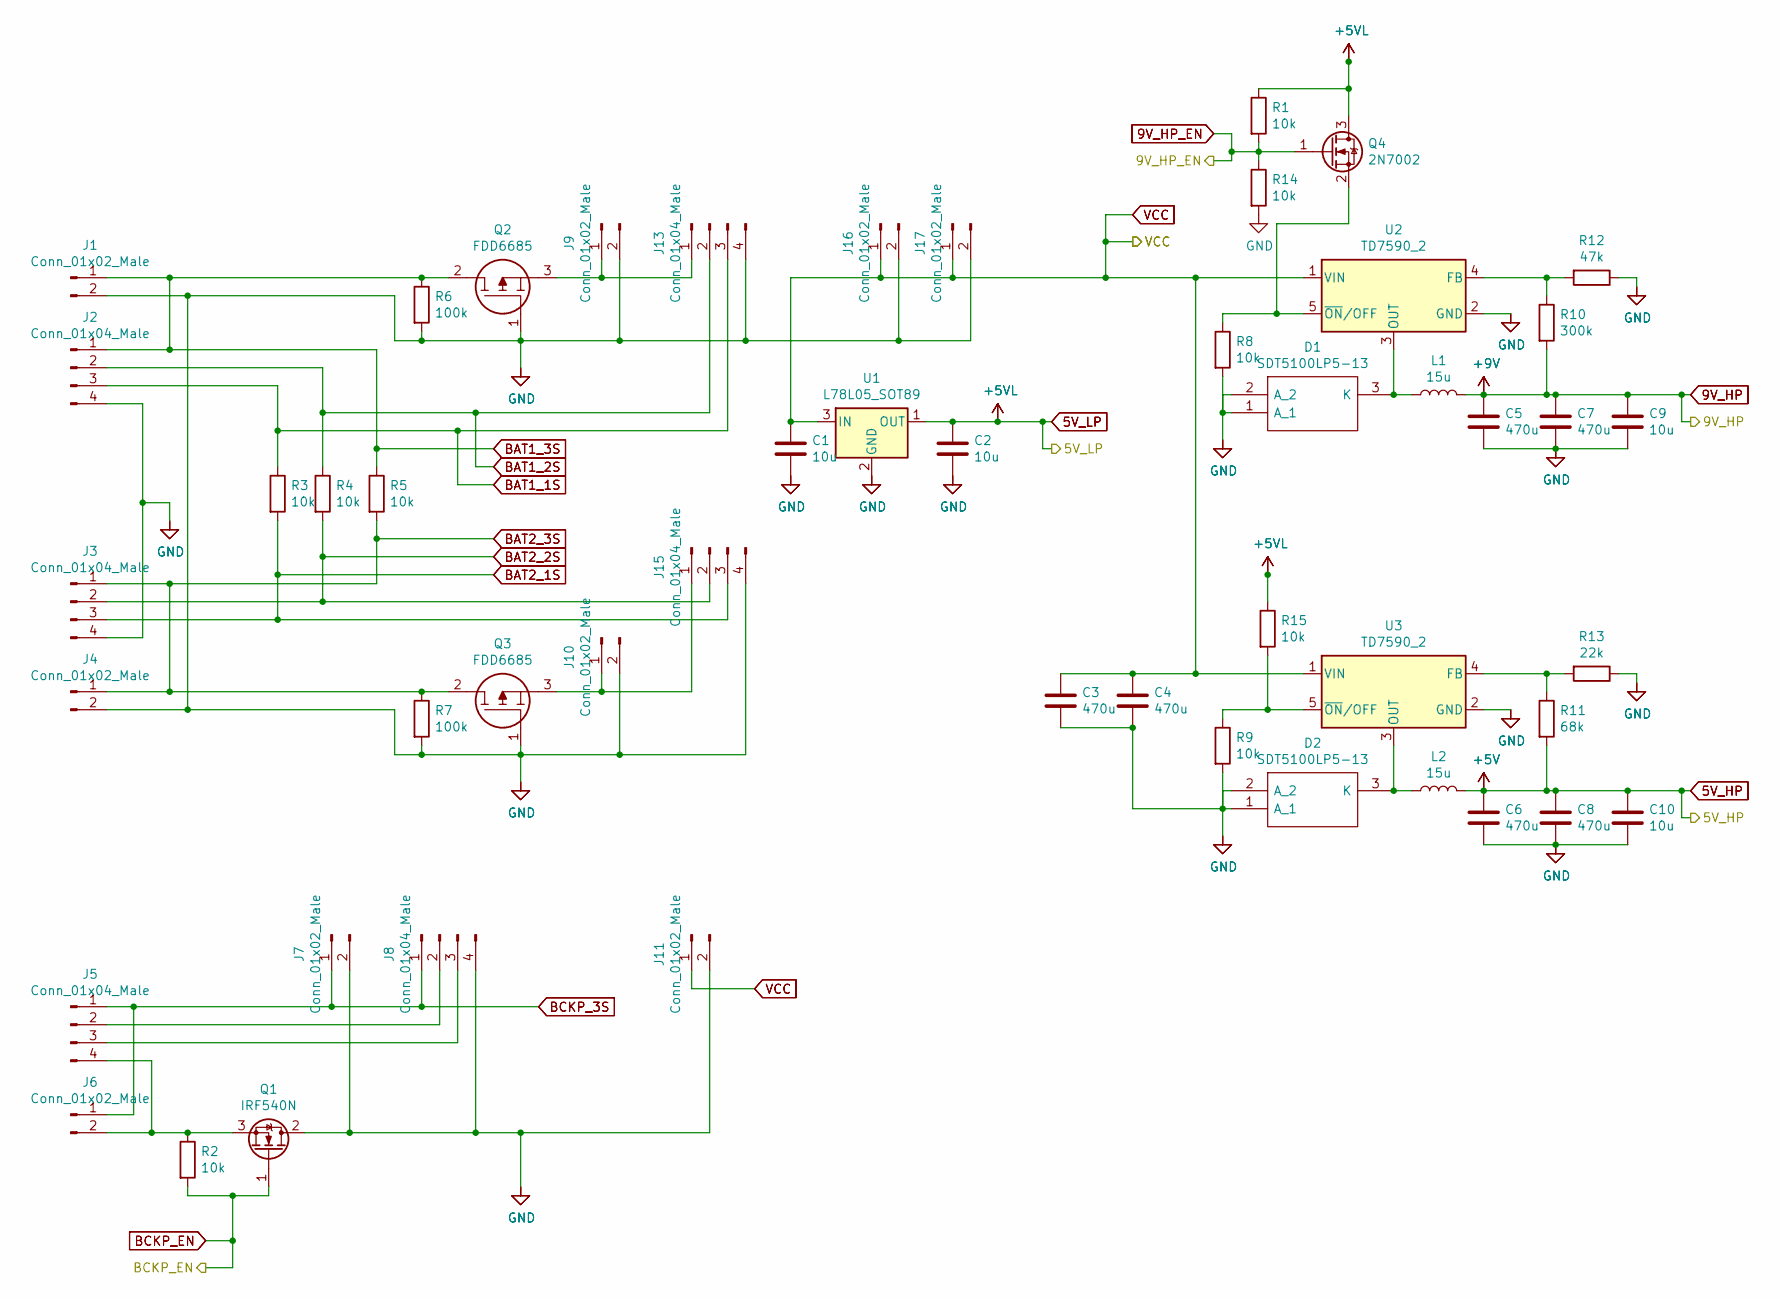
[picture p28: schematic PowerPCB.sch, Power buses generation and control]

Parts:
C1, C2: 10u; C_2512_6332Metric_Pad1.52x3.35mm_HandSolder
C3, C4: 470u; CP_Elec_10x12.5
C5, C6, C7, C8: 470u; CP_Radial_D10.0mm_P5.00mm
C9, C10: 10u; D_2512_6332Metric_Pad1.52x3.35mm_HandSolder
D1, D2: SDT5100LP5-13; D_PowerDI-5; Mouser Part Number 621-SDT5100LP5-13
J1, J4, J6, J7, J9, J10, J11, J16, J17: Conn_01x02_Male; SolderWirePad_1x02_P7.62mm_Drill2mm
J2, J3, J5, J8: Conn_01x04_Male; PinSocket_1x04_P2.54mm_Vertical
J13, J15: Conn_01x04_Male; PinHeader_1x04_P2.54mm_Vertical
L1, L2: 15u; L_7.3x7.3_H3.5
Q1: IRF540N; TO-220-3_Vertical
Q2, Q3: FDD6685; TO-252-3_TabPin2; Mouser Part Number 512-FDD6685
Q4: 2N7002; SOT-23
R1, R2, R3, R4, R5, R8, R9, R14, R15: 10k; R_0805_2012Metric_Pad1.15x1.40mm_HandSolder
R6, R7: 100k; R_0805_2012Metric_Pad1.15x1.40mm_HandSolder
R10: 300k; R_0805_2012Metric_Pad1.15x1.40mm_HandSolder
R11: 68k; R_0805_2012Metric_Pad1.15x1.40mm_HandSolder
R12: 47k; R_0805_2012Metric_Pad1.15x1.40mm_HandSolder
R13: 22k; R_0805_2012Metric_Pad1.15x1.40mm_HandSolder
U1: L78L05_SOT89; SOT-89-3
U2, U3: TD7590_2; TO-263-5_TabPin3

Connections:
5V_HP: C6.1, C8.1, C10.1, L2.2, R11.2; also elsewhere on the board
5V_LP: C2.1, Q4.3 (D), R1.1, R15.1, U1.1 (OUT)
9V_HP: C5.1, C7.1, C9.1, L1.2, R10.2; also elsewhere on the board
9V_HP_EN: Q4.1 (G), R1.2, R14.1; also elsewhere on the board
BAT1_1S: J2.3, J13.3, R3.1; also elsewhere on the board
BAT1_2S: J2.2, J13.2, R4.1; also elsewhere on the board
BAT1_3S: J1.1, J2.1, Q2.2, R5.1, R6.1; also elsewhere on the board
BAT2_1S: J3.3, J15.3, R3.2; also elsewhere on the board
BAT2_2S: J3.2, J15.2, R4.2; also elsewhere on the board
BAT2_3S: J3.1, J4.1, Q3.2, R5.2, R7.1; also elsewhere on the board
BCKP_3S: J5.1, J6.1, J7.1, J8.1; also elsewhere on the board
BCKP_EN: Q1.1 (G), R2.2; also elsewhere on the board
GND: C1.2, C2.2, C3.2, C4.2, C5.2, C6.2, C7.2, C8.2, C9.2, C10.2, D1.1 (A_1), D1.2 (A_2), D2.1 (A_1), D2.2 (A_2), J1.2, J2.4, J3.4, J4.2, J7.2, J8.4, J9.2, J10.2, J11.2, J13.4, J15.4, J16.2, J17.2, Q1.2 (D), Q2.1, Q3.1, R6.2, R7.2, R8.2, R9.2, R12.1, R13.1, R14.2, U1.2 (GND), U2.2 (GND), U3.2 (GND); also elsewhere on the board
unnamed: D1.3 (K), L1.1, U2.3 (OUT)
unnamed: D2.3 (K), L2.1, U3.3 (OUT)
unnamed: J5.2, J8.2
unnamed: J5.3, J8.3
unnamed: J5.4, J6.2, Q1.3 (S), R2.1
unnamed: J10.1, J15.1, Q3.3
unnamed: J9.1, J13.1, Q2.3
unnamed: Q4.2 (S), R8.1, U2.5 (~ON~/OFF)
unnamed: R10.1, R12.2, U2.4 (FB)
unnamed: R11.1, R13.2, U3.4 (FB)
unnamed: R9.1, R15.2, U3.5 (~ON~/OFF)
VCC: C1.1, C3.1, C4.1, J11.1, J16.1, J17.1, U1.3 (IN), U2.1 (VIN), U3.1 (VIN)

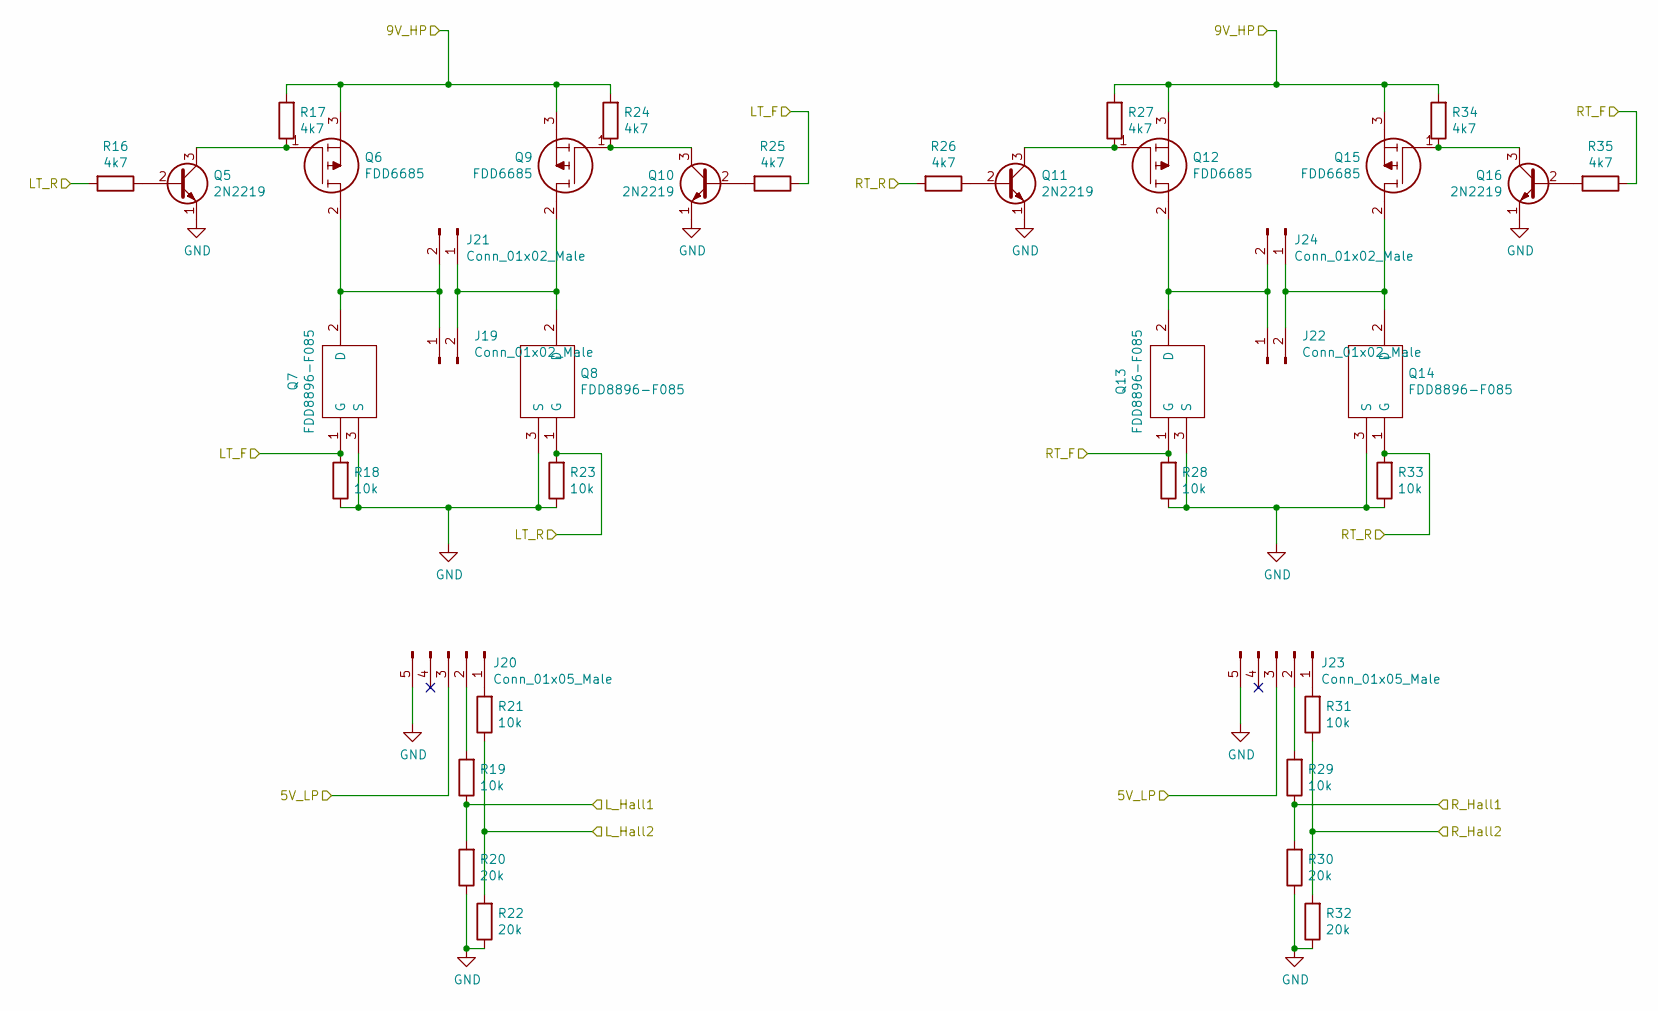
[picture p29: schematic MotorControl.sch]

Parts:
J19, J21, J22, J24: Conn_01x02_Male; PinHeader_1x02_P2.54mm_Vertical
J20, J23: Conn_01x05_Male; PinHeader_1x05_P2.54mm_Vertical
Q5, Q10, Q11, Q16: 2N2219; TO-39-3
Q6, Q9, Q12, Q15: FDD6685; TO-252-3_TabPin2; Mouser Part Number 512-FDD6685
Q7, Q8, Q13, Q14: FDD8896-F085; TO-252-3_TabPin2; Mouser Part Number 512-FDD8896_F085
R16, R17, R24, R25, R26, R27, R34, R35: 4k7; R_0805_2012Metric_Pad1.15x1.40mm_HandSolder
R18, R19, R21, R23, R28, R29, R31, R33: 10k; R_0805_2012Metric_Pad1.15x1.40mm_HandSolder
R20, R22, R30, R32: 20k; R_0805_2012Metric_Pad1.15x1.40mm_HandSolder

Connections:
5V_HP: J20.3, J23.3; also elsewhere on the board
9V_HP: Q6.3, Q9.3, Q12.3, Q15.3, R17.2, R24.2, R27.2, R34.2; also elsewhere on the board
/Control Logic/LHall1: R19.1, R20.2; also elsewhere on the board
/Control Logic/LHall2: R21.1, R22.2; also elsewhere on the board
/Control Logic/LT_R: Q8.1 (G), R16.2, R23.2; also elsewhere on the board
/Control Logic/RHall1: R29.1, R30.2; also elsewhere on the board
/Control Logic/RHall2: R31.1, R32.2; also elsewhere on the board
/Control Logic/RT_R: Q14.1 (G), R26.2, R33.2; also elsewhere on the board
/Motor Control/LT_F: Q7.1 (G), R18.2, R25.1; also elsewhere on the board
/Motor Control/RT_F: Q13.1 (G), R28.2, R35.1; also elsewhere on the board
GND: J20.5, J23.5, Q5.1 (E), Q7.3 (S), Q8.3 (S), Q10.1 (E), Q11.1 (E), Q13.3 (S), Q14.3 (S), Q16.1 (E), R18.1, R20.1, R22.1, R23.1, R28.1, R30.1, R32.1, R33.1; also elsewhere on the board
unnamed: J19.1, J21.2, Q6.2, Q7.2 (D)
unnamed: J19.2, J21.1, Q8.2 (D), Q9.2
unnamed: J20.1, R21.2
unnamed: J20.2, R19.2
unnamed: J22.1, J24.2, Q12.2, Q13.2 (D)
unnamed: J22.2, J24.1, Q14.2 (D), Q15.2
unnamed: J23.1, R31.2
unnamed: J23.2, R29.2
unnamed: Q5.2 (B), R16.1
unnamed: Q5.3 (C), Q6.1, R17.1
unnamed: Q10.2 (B), R25.2
unnamed: Q9.1, Q10.3 (C), R24.1
unnamed: Q11.2 (B), R26.1
unnamed: Q11.3 (C), Q12.1, R27.1
unnamed: Q15.1, Q16.3 (C), R34.1
unnamed: Q16.2 (B), R35.2

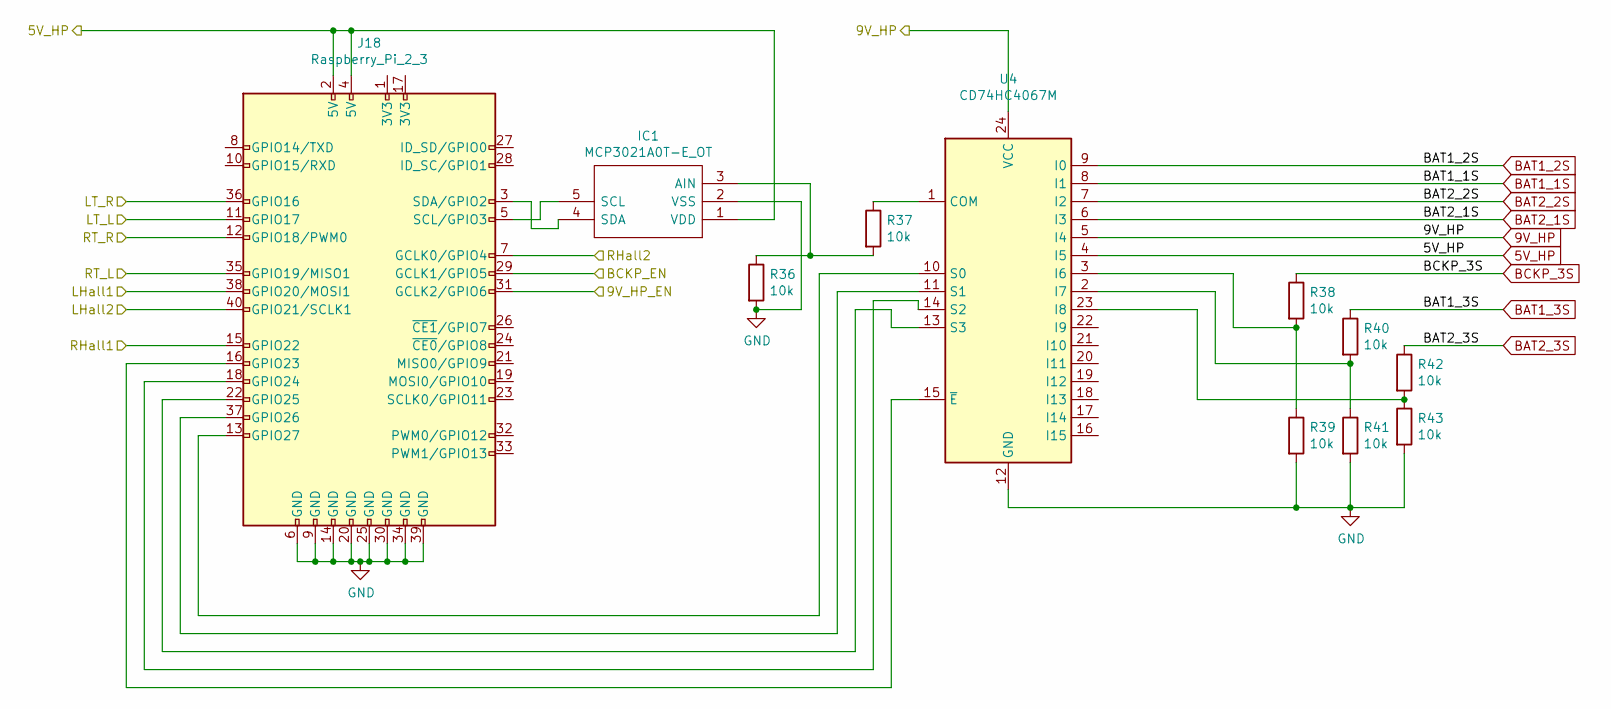
[picture p30: schematic ControlLogic.sch]

Parts:
IC1: MCP3021A0T-E_OT; SOT-23-5; Mouser Part Number 579-MCP3021A0T-E/OT
J18: Raspberry_Pi_2_3; PinSocket_2x20_P2.54mm_Vertical
R36, R37, R38, R39, R40, R41, R42, R43: 10k; R_0805_2012Metric_Pad1.15x1.40mm_HandSolder
U4: CD74HC4067M; SOIC-24W_7.5x15.4mm_P1.27mm

Connections:
5V_HP: IC1.1 (VDD), J18.2 (5V), J18.4 (5V), U4.4 (I5); also elsewhere on the board
9V_HP: U4.5 (I4), U4.24 (VCC); also elsewhere on the board
9V_HP_EN: J18.31 (GCLK2/GPIO6); also elsewhere on the board
/Control Logic/LHall1: J18.38 (GPIO20/MOSI1); also elsewhere on the board
/Control Logic/LHall2: J18.40 (GPIO21/SCLK1); also elsewhere on the board
/Control Logic/LT_R: J18.36 (GPIO16); also elsewhere on the board
/Control Logic/RHall1: J18.15 (GPIO22); also elsewhere on the board
/Control Logic/RHall2: J18.7 (GCLK0/GPIO4); also elsewhere on the board
/Control Logic/RT_R: J18.12 (GPIO18/PWM0); also elsewhere on the board
/Motor Control/LT_F: J18.11 (GPIO17); also elsewhere on the board
/Motor Control/RT_F: J18.35 (GPIO19/MISO1); also elsewhere on the board
BAT1_1S: U4.8 (I1); also elsewhere on the board
BAT1_2S: U4.9 (I0); also elsewhere on the board
BAT1_3S: R40.1; also elsewhere on the board
BAT2_1S: U4.6 (I3); also elsewhere on the board
BAT2_2S: U4.7 (I2); also elsewhere on the board
BAT2_3S: R42.1; also elsewhere on the board
BCKP_3S: R38.1; also elsewhere on the board
BCKP_EN: J18.29 (GCLK1/GPIO5); also elsewhere on the board
GND: IC1.2 (VSS), J18.6 (GND), J18.9 (GND), J18.14 (GND), J18.20 (GND), J18.25 (GND), J18.30 (GND), J18.34 (GND), J18.39 (GND), R36.2, R39.2, R41.2, R43.2, U4.12 (GND); also elsewhere on the board
unnamed: IC1.3 (AIN), R36.1, R37.2
unnamed: IC1.4 (SDA), J18.3 (SDA/GPIO2)
unnamed: IC1.5 (SCL), J18.5 (SCL/GPIO3)
unnamed: J18.13 (GPIO27), U4.10 (S0)
unnamed: J18.16 (GPIO23), U4.15 (~E)
unnamed: J18.18 (GPIO24), U4.14 (S2)
unnamed: J18.22 (GPIO25), U4.13 (S3)
unnamed: J18.37 (GPIO26), U4.11 (S1)
unnamed: R37.1, U4.1 (COM)
unnamed: R38.2, R39.1, U4.3 (I6)
unnamed: R40.2, R41.1, U4.2 (I7)
unnamed: R42.2, R43.1, U4.23 (I8)

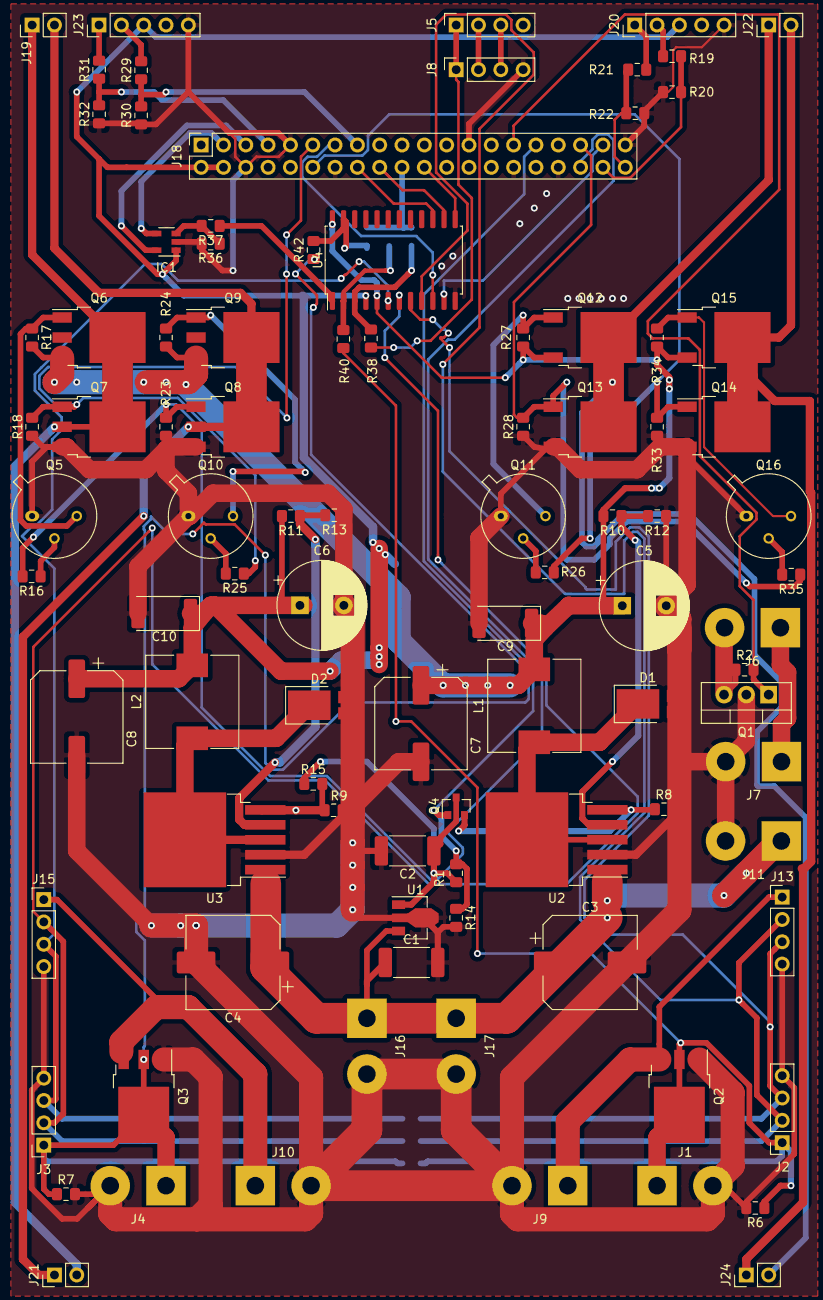
[picture p31: board TFG_PCB.kicad_pcb from above]

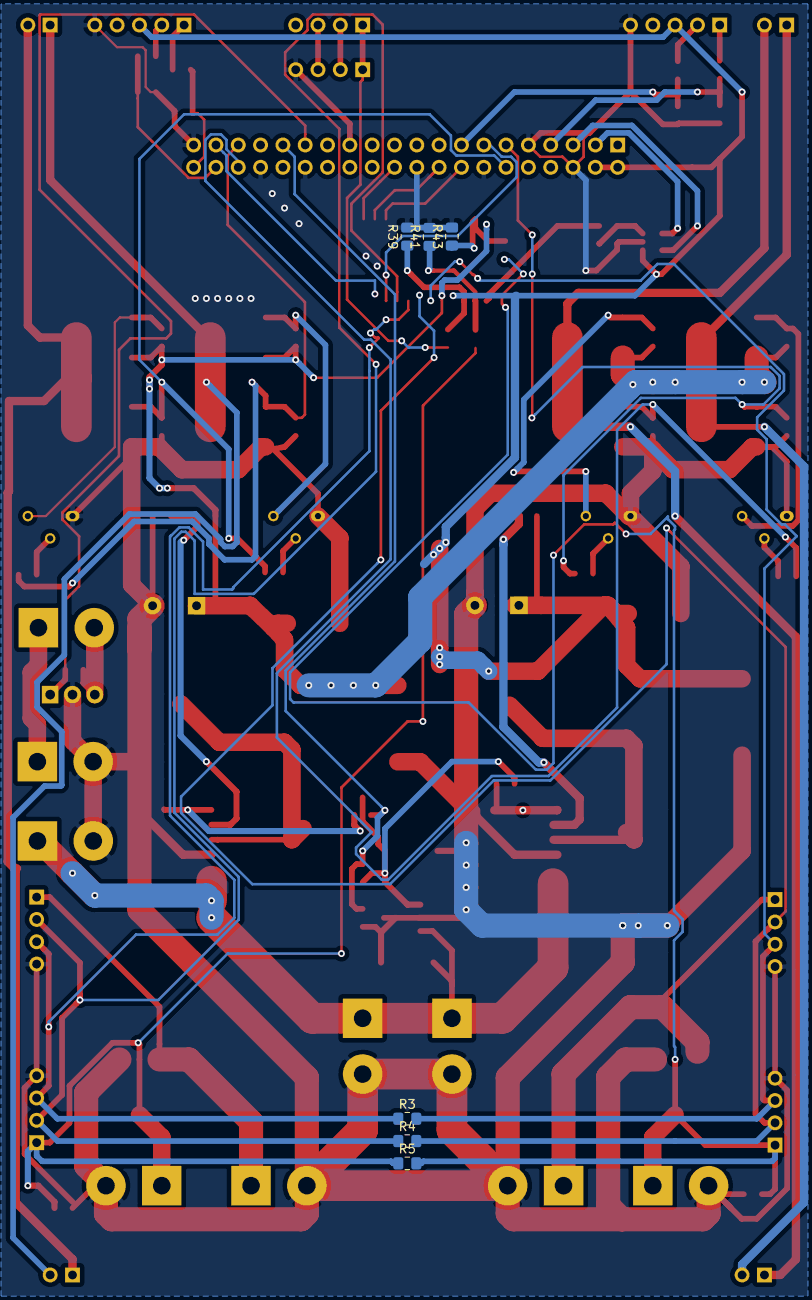
[picture p32: board TFG_PCB.kicad_pcb from below]

Board: 2 copper layers, 100 parts (6 on the bottom side), 61 nets.
