jordi2224/DQNavigator/resuse.py

import os
import random
from tqdm import tqdm
import tensorflow as tf
from keras.callbacks import TensorBoard
import time
from collections import deque
import numpy as np
from keras.models import Sequential
from keras.layers import Dense, Dropout, Conv1D, Activation, MaxPooling2D, Flatten
from test_1_tank_controls.retrainingenv import Environment

EPISODES = 2_000
REPLAY_MEMORY_SIZE = 2_000
MIN_REPLAY_MEMORY_SIZE = 1_000
MODEL_NAME = "sequential"

MINIBATCH_SIZE = 32

DISCOUNT = 0.99
UPDATE_TARGET_EVERY = 20  # Terminal states (end of episodes)

# Exploration settings
epsilon = 0.99  # not a constant, going to be decayed
EPSILON_DECAY = 0.9998
MIN_EPSILON = 0.001

env = Environment()

AGGREGATE_STATS_EVERY = 50  # episodes

MIN_REWARD = -500  # For model save

# Own Tensorboard class
class ModifiedTensorBoard(TensorBoard):

    # Overriding init to set initial step and writer (we want one log file for all .fit() calls)
    def __init__(self, **kwargs):
        super().__init__(**kwargs)
        self.step = 1
        self.writer = tf.summary.create_file_writer(self.log_dir)

    # Overriding this method to stop creating default log writer
    def set_model(self, model):
        pass

    # Overrided, saves logs with our step number
    # (otherwise every .fit() will start writing from 0th step)
    def on_epoch_end(self, epoch, logs=None):
        #self.update_stats(**logs)
        pass

    # Overrided
    # We train for one batch only, no need to save anything at epoch end
    def on_batch_end(self, batch, logs=None):
        pass

    # Overrided, so won't close writer
    def on_train_end(self, _):
        pass

    # Custom method for saving own metrics
    # Creates writer, writes custom metrics and closes writer
    def update_stats(self, **stats):
        with self.writer.as_default():
            print(stats.get('reward_avg'))
            tf.summary.scalar('reward_avg', stats.get('reward_avg'), step=stats.get('episode'))


class DQNAgent:

    def __init__(self):

        # main model
        self.model = self.create_model()

        # Target network
        self.target_model = self.create_model()
        self.target_model.set_weights(self.model.get_weights())

        # An array with last n steps for training
        self.replay_memory = deque(maxlen=REPLAY_MEMORY_SIZE)

        # Custom tensorboard object
        self.tensorboard = ModifiedTensorBoard(log_dir="logs/{}-{}".format(MODEL_NAME, int(time.time())))

        # Used to count when to update target network with main network's weights
        self.target_update_counter = 0

    def create_model(self):
        model = Sequential()
        model.add(Dense(25, input_dim=env.state_size, activation='relu'))
        model.add(Dense(32, activation='relu'))
        model.add(Dropout(0.5))
        model.add(Dense(32, activation='relu'))
        model.add(Dense(4, activation='linear'))

        model.compile(loss='binary_crossentropy', optimizer='adam', metrics=['accuracy'])

        return model

    # Adds step's data to a memory replay array
    # (observation space, action, reward, new observation space, done)
    def update_replay_memory(self, transition):
        self.replay_memory.append(transition)

    # Queries main network for Q values given current observation space (environment state)
    def get_qs(self, state):
        return self.model.predict(np.array(state).reshape(-1, *state.shape))[0]

    # Trains main network every step during episode
    def train(self, terminal_state, step):

        # Start training only if certain number of samples is already saved
        if len(self.replay_memory) < MIN_REPLAY_MEMORY_SIZE:
            return

        # Get a minibatch of random samples from memory replay table
        minibatch = random.sample(self.replay_memory, MINIBATCH_SIZE)

        # Get current states from minibatch, then query NN model for Q values
        current_states = np.array([transition[0] for transition in minibatch])
        current_qs_list = self.model.predict(current_states)

        # Get future states from minibatch, then query NN model for Q values
        # When using target network, query it, otherwise main network should be queried
        new_current_states = np.array([transition[3] for transition in minibatch]) / 255
        future_qs_list = self.target_model.predict(new_current_states)

        X = []
        y = []

        # Now we need to enumerate our batches
        for index, (current_state, action, reward, new_current_state, done) in enumerate(minibatch):

            # If not a terminal state, get new q from future states, otherwise set it to 0
            # almost like with Q Learning, but we use just part of equation here
            if not done:
                max_future_q = np.max(future_qs_list[index])
                new_q = reward + DISCOUNT * max_future_q
            else:
                new_q = reward

            # Update Q value for given state
            current_qs = current_qs_list[index]
            current_qs[action] = new_q

            # And append to our training data
            X.append(current_state)
            y.append(current_qs)

        # Fit on all samples as one batch, log only on terminal state
        self.model.fit(np.array(X), np.array(y), batch_size=MINIBATCH_SIZE, verbose=0, shuffle=False,
                       callbacks=[self.tensorboard] if terminal_state else None)

        # Update target network counter every episode
        if terminal_state:
            self.target_update_counter += 1

        # If counter reaches set value, update target network with weights of main network
        if self.target_update_counter > UPDATE_TARGET_EVERY:
            self.target_model.set_weights(self.model.get_weights())
            self.target_update_counter = 0


if __name__ == "__main__":
    agent = DQNAgent()
    agent.model.load_weights("models/retrained/sequential__4282.00max_4096.72avg_3925.00min__1576877641.model")
    agent.model.compile(loss='binary_crossentropy', optimizer='adam', metrics=['accuracy'])
    # For stats
    ep_rewards = [-200]

    env.render()

    # For more repetitive results
    random.seed(1)
    np.random.seed(1)
    tf.random.set_seed(1)
    best_average_reward = -100000
    best_model = ""

    if not os.path.isdir('models/retrained'):
        os.makedirs('models/retrained')

    for episode in tqdm(range(1, EPISODES + 1), ascii=True, unit='episodes'):

        # Update tensorboard step every episode
        agent.tensorboard.step = episode

        # Restarting episode - reset episode reward and step number
        episode_reward = 0
        step = 1

        done = False
        env, reward, current_state, done = env.reset()

        if (episode == EPISODES):
            env.render()

        while not done:
            # This part stays mostly the same, the change is to query a model for Q values
            if np.random.random() > epsilon:
                # Get action from Q table
                action = np.argmax(agent.get_qs(np.array(current_state)))
            else:
                # Get random action
                action = np.random.randint(0, env.ACTION_SPACE_SIZE)

            reward, new_state, done = env.step(action)
            reward = reward/10
            # Transform new continous state to new discrete state and count reward
            episode_reward += reward

            '''if SHOW_PREVIEW and not episode % AGGREGATE_STATS_EVERY:
                env.render()'''

            # Every step we update replay memory and train main network
            agent.update_replay_memory((current_state, action, reward, new_state, done))
            agent.train(done, step)
            current_state = new_state
            step += 1

        # Append episode reward to a list and log stats (every given number of episodes)
        ep_rewards.append(episode_reward)
        if not episode % AGGREGATE_STATS_EVERY or episode == 1:
            average_reward = sum(ep_rewards[-AGGREGATE_STATS_EVERY:]) / len(ep_rewards[-AGGREGATE_STATS_EVERY:])
            min_reward = min(ep_rewards[-AGGREGATE_STATS_EVERY:])
            max_reward = max(ep_rewards[-AGGREGATE_STATS_EVERY:])
            agent.tensorboard.update_stats(reward_avg=average_reward, reward_min=min_reward, reward_max=max_reward,
                                           epsilon=epsilon, episode=episode)
            print("epsilon: ", epsilon)

            # Save model, but only when min reward is greater or equal a set value
            if average_reward >= MIN_REWARD:
                agent.model.save(
                    f'models/retrained/{MODEL_NAME}__{max_reward:_>7.2f}max_{average_reward:_>7.2f}avg_{min_reward:_>7.2f}min__{int(time.time())}.model')

                if(average_reward > best_average_reward):
                    best_model = f'models/retrained/{MODEL_NAME}__{max_reward:_>7.2f}max_{average_reward:_>7.2f}avg_{min_reward:_>7.2f}min__{int(time.time())}.model'

        # Decay epsilon
        if epsilon > MIN_EPSILON:
            epsilon *= EPSILON_DECAY
            epsilon = max(MIN_EPSILON, epsilon)

    print(best_model)
