jordi2224/DQNavigator/controller/server_tools.py

import os
import pickle
import subprocess

import controller.async_movement
from controller.GPIOdefinitions import *
from controller.comm_definitions import *
from driver.TSFinalDriver import Driver

# Default status configuration
start_USB_off = False
motor_enable = True

# Scan configuration
sample_size = 600
default_max_distance = 5000


# Main execution function
def execute(msg, driver, dsize, conn):
    """
    Decision making and execution function
    May be ran asynchronously in its own thread
    Multithreading execution is imposed by some orders since they would fatally block the control loop's execution

    Input parameters:
    msg: message, dict containing order type and parameters for execution
    driver: LIDAR driver object. May be None if the sensor was not plugged in when initialized
    dsize: LIDAR data size
    conn: connection object to controller. Used to send replies. DO NOT READ FROM THIS OBJECT
    """
    global motor_enable, sample_size

    if msg["type"] == "HALT_OVERRIDE":
        controller.async_movement.override_halt()
        halt()
        print("EMERGENCY HALT EXECUTED!")
    elif msg["type"] == "MANUAL_MOVE_ORDER" and motor_enable:
        dir = msg["direction"]
        if dir == "FWD":
            forward()
        elif dir == "BWD":
            backwards()
        elif dir == "LEFT":
            reverse_right()
            forward_left()
        elif dir == "RIGHT":
            forward_right()
            reverse_left()
        elif dir == "HALT":
            halt()

    elif msg["type"] == "CONTROLLED_MOVE_ORDER" and motor_enable:
        print("Received a controlled move order")
        controller.async_movement.execute_move(msg["value"], msg["movement"], conn)

    elif msg["type"] == "CONFIGURATION":
        device = msg["target"]

        if device == "MOTOR":
            if msg["state"] == 1:
                print("Motor movement enabled by client")
                motor_enable = True
            elif msg["state"] == 0:
                print("Motor movement disabled by client")
                motor_enable = False
            else:
                print('Unexpected value')
        elif device == "USB":
            if msg["state"] == 1:
                os.system('echo \'1-1\' |sudo tee /sys/bus/usb/drivers/usb/bind')
            elif msg["state"] == 0:
                os.system('echo \'1-1\' |sudo tee /sys/bus/usb/drivers/usb/unbind')
            else:
                print('Unexpected value')

        elif device == "PARAMETER":
            if msg["parameter"] == "SAMPLE_SIZE":
                value = msg["value"]
                sample_size = value

            elif msg["parameter"] == "MAX_DISTANCE":
                value = msg["value"]
                max_distance = value
            else:
                print('Unexpected value')

        else:
            print("Unsupported device")

    elif msg["type"] == "REQUEST":
        request = msg["request"]

        if request == "GET_SCAN":
            if driver is not None:
                driver.connection.flush()
                if "MAX_RANGE" in msg:
                    max_distance = msg["MAX_RANGE"]
                else:
                    max_distance = default_max_distance
                if "SAMPLE_SIZE" in msg:
                    points, x, y = driver.get_point_cloud(dsize, msg["SAMPLE_SIZE"], max_distance)
                else:
                    points, x, y = driver.get_point_cloud(dsize, sample_size, max_distance)

                print("Sending scan data")
                serialized_p = pickle.dumps(points, protocol=0)
                res = START_STR + "{\"type\":\"SCAN_DATA\", \"data_size\": " + str(len(serialized_p)) + " }" + END_STR
                conn.send(res.encode('utf-8'))
                conn.send(DATA_START_STR.encode('utf-8') + serialized_p + DATA_END_STR.encode('utf-8'))

            else:
                res = {"type": "ERROR", "severity": 1,
                       "message": "No driver is running at the moment, is the LIDAR connected?"}
                res = START_STR + str(res).replace('\'', '\"') + END_STR
                conn.send(res.encode('utf-8'))
                print("Controller attempted to retrieve LIDAR data but to driver is running")

    else:
        print("Unknown message")


def start_driver():
    """Attempts to create a driver object for A1 LIDAR"""

    # Get kernel message buffer (there might be a more elegant way but this is very *very* fast)
    s = subprocess.check_output(['dmesg'])
    s = s.split(b'\n')
    port = None

    # Look for Unix-like message regarding device attachment
    # We are looking for the last assignment hence the reverse search
    for line in reversed(s):
        if b'cp210x converter now attached to' in line:
            port = line[line.find(b'ttyUSB'):len(line)]
            break

    # Returns None object if no port could be found
    if not port:
        print("LIDAR is not connected")
        return None, None

    # Otherwise start the driver on that port
    # We return the data size, this is likely to be removed in future versions TODO
    driver = Driver('/dev/' + port.decode('utf-8'))
    dsize = driver.start_scan_express()

    return driver, dsize
