jordi2224/DQNavigator/(commit log)

2020-01-23 Added LIDAR documentation
2020-01-23 Initial deck CAD drawings
    [Deck0.SLDPRT]
2020-01-23 Initial KiCad PCB project
    [TFG_PCB.kicad_pcb, TFG_PCB.sch]
2020-01-24 Power buses with backup battery circuit
2020-01-24 Added hierarchy and logic sheet
    [ControlLogic.sch, PowerPCB.sch, TFG_PCB.sch]
2020-01-25 Added 40pin GPIO control circuitry
2020-01-27 Python driver for RPLIDAR
2020-01-30 added footprints
    [ControlLogic.sch, PowerPCB.sch, TFG_PCB.sch]
2020-02-26 netlist and Motor Control sheet
    [ControlLogic.sch, MotorControl.sch, PowerPCB.sch, TFG_PCB.sch]
2020-02-27 Updated netlist and footprints
    [ControlLogic.sch, PowerPCB.sch, TFG_PCB.sch]
2020-03-16 Object driver and wall detection
    [TFG_PCB.kicad_pcb]
2020-03-25 GPIO controller for motors
2020-03-26 Fixed some bugs and GPIO assignments
    [GPIOdefinitions.py, server_start.py]
2020-04-13 Added server-side driver support
2020-04-13 fixed ttyUSB port linking
    [server_tools.py]
2020-04-13 [UNSTABLE] Experimental networking multithreading
    [TSFinalDriver.py, server_start.py, server_tools.py]
2020-04-14 Added motor disable message and fixes
    [comm_definitions.py, manual_controller.py, server_tools.py]
2020-05-22 Prototype counter for position tracking
2020-05-22 Updated pins and position counters
    [LIDAR_support.0006.ipt, battery-strap -under.0001.ipt]
2020-05-23 Added no driver mode
2020-05-24 Testing async threading for movement
2020-05-24 Added channel activity to prevent manual control from stopping running commands
    [server_start.py]
2020-05-27 Updated LIDAR support for increased strength and cable cutouts
    [LIDAR_support.0005.ipt, LIDAR_support.0006.ipt, LIDAR_support.0009.ipt, LIDAR_support.ipt, LIDAR_support.stl]
2020-05-27 Testing how to clear the stale samples
2020-05-27 Testing interrupt based tracking
2020-05-27 Fixing interrupt based tracking
    [async_counter_interrupt.py]
2020-05-28 Attempting to fix manual halting
    [GPIOdefinitions.py, manual_controller.py]
2020-05-28 Fixing infinite loop in precise movement control
    [async_movement.py, manual_controller.py]
2020-05-29 Adding position reporting and LIDAR synch testing
2020-05-31 Modifying the interrupt based routines
2020-05-31 Added documentation and fine tunning of interrupt base tracking
2020-06-01 Added broken pipe error handling + tweaking
    [TSFinalDriver.py, server_start.py]
2020-06-02 Added reporting and linear correction
    [async_movement.py, corrected_movement.py, manual_controller.py]
2020-06-02 Added driver stream resynch and linear LIDAR movement correction
    [TSFinalDriver.py, corrected_movement.py]
2020-06-07 Hardware revision and bugfixes
    [PCB_deck.stl]
